Akshaybunny18/5bit-CLA-Adder-VLSI/Verilog/FPGA/project_1.runs/impl_1/.vivado.begin.rst

<?xml version="1.0"?>
<ProcessHandle Version="1" Minor="0">
    <Process Command="vivado.bat" Owner="aksha" Host="BUNNY" Pid="77792" HostCore="0" HostMemory="0">
    </Process>
</ProcessHandle>
<?xml version="1.0"?>
<ProcessHandle Version="1" Minor="0">
    <Process Command="vivado.bat" Owner="aksha" Host="BUNNY" Pid="55608" HostCore="0" HostMemory="0">
    </Process>
</ProcessHandle>
<?xml version="1.0"?>
<ProcessHandle Version="1" Minor="0">
    <Process Command="vivado.bat" Owner="aksha" Host="BUNNY" Pid="72820" HostCore="0" HostMemory="0">
    </Process>
</ProcessHandle>
<?xml version="1.0"?>
<ProcessHandle Version="1" Minor="0">
    <Process Command="vivado.bat" Owner="aksha" Host="BUNNY" Pid="8096" HostCore="0" HostMemory="0">
    </Process>
</ProcessHandle>
