Akshaybunny18/5bit-CLA-Adder-VLSI/Verilog/FPGA/project_1.runs/synth_1/.vivado.begin.rst

<?xml version="1.0"?>
<ProcessHandle Version="1" Minor="0">
    <Process Command="vivado.bat" Owner="aksha" Host="BUNNY" Pid="38688" HostCore="0" HostMemory="0">
    </Process>
</ProcessHandle>
