Akshaybunny18/5bit-CLA-Adder-VLSI/Ngspice/Post_Layout/ckt_final.cir

* Chanda Akshay Kumar 2024102014 VLSI Design
.include TSMC_180nm.txt
.param LAMBDA = 0.09u
.global gnd vdd

* Testbench
vdd vdd gnd 1.8


* SPICE3 file created from ckt_copy.ext - technology: scmos

.option scale=0.09u

M1000 vdd a_23_n261# a_94_n229# w_88_n235# CMOSP w=40 l=2
+  ad=16600 pd=6510 as=400 ps=180
M1001 g2 a_94_n331# vdd w_214_n354# CMOSP w=40 l=2
+  ad=200 pd=90 as=0 ps=0
M1002 gnd b3 a_156_n473# Gnd CMOSN w=40 l=2
+  ad=13100 pd=5840 as=240 ps=92
M1003 vdd a_851_n313# s3 w_925_n287# CMOSP w=40 l=2
+  ad=0 pd=0 as=400 ps=180
M1004 a_396_n200# g1 vdd w_390_n206# CMOSP w=40 l=2
+  ad=400 pd=180 as=0 ps=0
M1005 a_913_n196# p2 a_851_n203# Gnd CMOSN w=40 l=2
+  ad=240 pd=92 as=200 ps=90
M1006 vdd a_397_n323# a_576_n345# w_570_n351# CMOSP w=40 l=2
+  ad=0 pd=0 as=640 ps=272
M1007 a_913_n87# p1 a_851_n94# Gnd CMOSN w=40 l=2
+  ad=240 pd=92 as=200 ps=90
M1008 vdd b1 a_23_n111# w_17_n117# CMOSP w=40 l=2
+  ad=0 pd=0 as=400 ps=180
M1009 a_94_n331# b2 vdd w_88_n337# CMOSP w=40 l=2
+  ad=400 pd=180 as=0 ps=0
M1010 a_396_n521# g1 vdd w_390_n527# CMOSP w=40 l=2
+  ad=640 pd=272 as=0 ps=0
M1011 a_851_n30# g0 vdd w_845_n36# CMOSP w=40 l=2
+  ad=400 pd=180 as=0 ps=0
M1012 s2 a_851_n139# vdd w_925_n177# CMOSP w=40 l=2
+  ad=400 pd=180 as=0 ps=0
M1013 gnd a_23_n560# a_156_n585# Gnd CMOSN w=40 l=2
+  ad=0 pd=0 as=240 ps=92
M1014 c5 a_396_n459# a_608_n570# Gnd CMOSN w=100 l=2
+  ad=500 pd=210 as=600 ps=212
M1015 s4 a_851_n360# vdd w_925_n398# CMOSP w=40 l=2
+  ad=400 pd=180 as=0 ps=0
M1016 vdd a_94_n143# p1 w_168_n117# CMOSP w=40 l=2
+  ad=0 pd=0 as=400 ps=180
M1017 vdd p1 a_396_n459# w_390_n472# CMOSP w=40 l=2
+  ad=0 pd=0 as=680 ps=274
M1018 a_452_n277# p3 gnd Gnd CMOSN w=80 l=2
+  ad=480 pd=172 as=0 ps=0
M1019 vdd a3 a_94_n480# w_88_n486# CMOSP w=40 l=2
+  ad=0 pd=0 as=400 ps=180
M1020 a_913_n417# p4 a_851_n424# Gnd CMOSN w=40 l=2
+  ad=240 pd=92 as=200 ps=90
M1021 a_94_n32# b0 vdd w_88_n38# CMOSP w=40 l=2
+  ad=400 pd=180 as=0 ps=0
M1022 a_452_n498# p2 a_452_n506# Gnd CMOSN w=80 l=2
+  ad=480 pd=172 as=480 ps=172
M1023 a_396_n56# g0 vdd w_390_n62# CMOSP w=40 l=2
+  ad=400 pd=180 as=0 ps=0
M1024 a_236_n254# a_94_n293# p2 Gnd CMOSN w=40 l=2
+  ad=240 pd=92 as=200 ps=90
M1025 a_913_n132# a_780_n171# a_851_n139# Gnd CMOSN w=40 l=2
+  ad=240 pd=92 as=200 ps=90
M1026 a_913_n353# a_780_n392# a_851_n360# Gnd CMOSN w=40 l=2
+  ad=240 pd=92 as=200 ps=90
M1027 g4 a_94_n630# gnd Gnd CMOSN w=20 l=2
+  ad=100 pd=50 as=0 ps=0
M1028 a_913_n23# a_780_n62# a_851_n30# Gnd CMOSN w=40 l=2
+  ad=240 pd=92 as=200 ps=90
M1029 a_780_n62# g0 vdd w_774_n68# CMOSP w=40 l=2
+  ad=400 pd=180 as=0 ps=0
M1030 a_156_n174# a1 a_94_n181# Gnd CMOSN w=40 l=2
+  ad=240 pd=92 as=200 ps=90
M1031 a_851_n203# a_780_n171# vdd w_845_n209# CMOSP w=40 l=2
+  ad=400 pd=180 as=0 ps=0
M1032 a_397_n323# p3 vdd w_391_n336# CMOSP w=40 l=2
+  ad=440 pd=182 as=0 ps=0
M1033 vdd b4 a_94_n592# w_88_n598# CMOSP w=40 l=2
+  ad=0 pd=0 as=400 ps=180
M1034 vdd a_23_38# a_94_70# w_88_64# CMOSP w=40 l=2
+  ad=0 pd=0 as=400 ps=180
M1035 vdd a_94_n181# a_563_n64# w_557_n70# CMOSP w=40 l=2
+  ad=0 pd=0 as=400 ps=180
M1036 vdd p3 a_851_n313# w_845_n319# CMOSP w=40 l=2
+  ad=0 pd=0 as=400 ps=180
M1037 a_576_n345# a_396_n284# a_632_n322# Gnd CMOSN w=80 l=2
+  ad=400 pd=170 as=480 ps=172
M1038 a_397_n560# p3 vdd w_391_n573# CMOSP w=40 l=2
+  ad=440 pd=182 as=0 ps=0
M1039 a_453_n560# p4 gnd Gnd CMOSN w=60 l=2
+  ad=360 pd=132 as=0 ps=0
M1040 gnd a4 a_156_n521# Gnd CMOSN w=40 l=2
+  ad=0 pd=0 as=240 ps=92
M1041 g1 a_94_n181# gnd Gnd CMOSN w=20 l=2
+  ad=100 pd=50 as=0 ps=0
M1042 a_396_n284# p2 vdd w_390_n290# CMOSP w=40 l=2
+  ad=640 pd=272 as=0 ps=0
M1043 a_396_n521# p3 vdd w_390_n527# CMOSP w=40 l=2
+  ad=0 pd=0 as=0 ps=0
M1044 a_458_n601# g3 a_396_n608# Gnd CMOSN w=40 l=2
+  ad=240 pd=92 as=200 ps=90
M1045 gnd a3 a_85_n403# Gnd CMOSN w=40 l=2
+  ad=0 pd=0 as=240 ps=92
M1046 a_23_n261# a2 vdd w_17_n267# CMOSP w=40 l=2
+  ad=400 pd=180 as=0 ps=0
M1047 vdd a_780_n281# a_851_n249# w_845_n255# CMOSP w=40 l=2
+  ad=0 pd=0 as=400 ps=180
M1048 a_156_n286# b2 a_94_n293# Gnd CMOSN w=40 l=2
+  ad=240 pd=92 as=200 ps=90
M1049 a_396_n459# p3 vdd w_390_n472# CMOSP w=40 l=2
+  ad=0 pd=0 as=0 ps=0
M1050 a_156_77# a_23_38# a_94_70# Gnd CMOSN w=40 l=2
+  ad=240 pd=92 as=200 ps=90
M1051 a_458_n49# p1 a_396_n56# Gnd CMOSN w=40 l=2
+  ad=240 pd=92 as=200 ps=90
M1052 a_452_n443# g0 a_452_n451# Gnd CMOSN w=100 l=2
+  ad=600 pd=212 as=600 ps=212
M1053 vdd a_851_n94# s1 w_925_n68# CMOSP w=40 l=2
+  ad=0 pd=0 as=400 ps=180
M1054 gnd g2 a_458_n364# Gnd CMOSN w=40 l=2
+  ad=0 pd=0 as=240 ps=92
M1055 gnd b0 a_156_n25# Gnd CMOSN w=40 l=2
+  ad=0 pd=0 as=240 ps=92
M1056 a_842_n55# p1 a_780_n62# Gnd CMOSN w=40 l=2
+  ad=240 pd=92 as=200 ps=90
M1057 a_642_n168# a_94_n331# gnd Gnd CMOSN w=60 l=2
+  ad=360 pd=132 as=0 ps=0
M1058 p2 a_94_n229# vdd w_168_n267# CMOSP w=40 l=2
+  ad=400 pd=180 as=0 ps=0
M1059 a_993_n55# a_851_n94# s1 Gnd CMOSN w=40 l=2
+  ad=240 pd=92 as=200 ps=90
M1060 a_396_n608# p4 vdd w_390_n614# CMOSP w=40 l=2
+  ad=400 pd=180 as=0 ps=0
M1061 a_851_n139# a_563_n64# vdd w_845_n145# CMOSP w=40 l=2
+  ad=400 pd=180 as=0 ps=0
M1062 a_94_n143# a_23_n111# vdd w_88_n149# CMOSP w=40 l=2
+  ad=400 pd=180 as=0 ps=0
M1063 vdd a_23_n560# a_94_n528# w_88_n534# CMOSP w=40 l=2
+  ad=0 pd=0 as=400 ps=180
M1064 vdd b0 a_94_6# w_88_0# CMOSP w=40 l=2
+  ad=0 pd=0 as=400 ps=180
M1065 g0 a_94_n32# gnd Gnd CMOSN w=20 l=2
+  ad=100 pd=50 as=0 ps=0
M1066 a_851_n360# a_576_n345# vdd w_845_n366# CMOSP w=40 l=2
+  ad=400 pd=180 as=0 ps=0
M1067 g4 a_94_n630# vdd w_214_n653# CMOSP w=40 l=2
+  ad=200 pd=90 as=0 ps=0
M1068 a_453_n315# g1 a_453_n323# Gnd CMOSN w=60 l=2
+  ad=360 pd=132 as=360 ps=132
M1069 a_608_n586# a_396_n608# a_608_n594# Gnd CMOSN w=100 l=2
+  ad=600 pd=212 as=600 ps=212
M1070 gnd a_94_70# a_236_45# Gnd CMOSN w=40 l=2
+  ad=0 pd=0 as=240 ps=92
M1071 a_842_n164# p2 a_780_n171# Gnd CMOSN w=40 l=2
+  ad=240 pd=92 as=200 ps=90
M1072 vdd a_396_n200# a_586_n168# w_580_n181# CMOSP w=40 l=2
+  ad=0 pd=0 as=440 ps=182
M1073 g1 a_94_n181# vdd w_215_n204# CMOSP w=40 l=2
+  ad=200 pd=90 as=0 ps=0
M1074 a_156_n222# a_23_n261# a_94_n229# Gnd CMOSN w=40 l=2
+  ad=240 pd=92 as=200 ps=90
M1075 a_452_n261# p1 a_452_n269# Gnd CMOSN w=80 l=2
+  ad=480 pd=172 as=480 ps=172
M1076 vdd b3 a_23_n410# w_17_n416# CMOSP w=40 l=2
+  ad=0 pd=0 as=400 ps=180
M1077 a_842_n385# p4 a_780_n392# Gnd CMOSN w=40 l=2
+  ad=240 pd=92 as=200 ps=90
M1078 a_156_13# b0 a_94_6# Gnd CMOSN w=40 l=2
+  ad=240 pd=92 as=200 ps=90
M1079 a_94_n630# b4 vdd w_88_n636# CMOSP w=40 l=2
+  ad=400 pd=180 as=0 ps=0
M1080 c5 a_397_n560# vdd w_546_n607# CMOSP w=40 l=2
+  ad=680 pd=274 as=0 ps=0
M1081 vdd p1 a_397_n152# w_391_n165# CMOSP w=40 l=2
+  ad=0 pd=0 as=440 ps=182
M1082 vdd a_94_n442# p3 w_168_n416# CMOSP w=40 l=2
+  ad=0 pd=0 as=400 ps=180
M1083 a_23_n111# a1 vdd w_17_n117# CMOSP w=40 l=2
+  ad=0 pd=0 as=0 ps=0
M1084 a_993_n274# a_851_n313# s3 Gnd CMOSN w=40 l=2
+  ad=240 pd=92 as=200 ps=90
M1085 vdd b0 a_23_38# w_17_32# CMOSP w=40 l=2
+  ad=0 pd=0 as=400 ps=180
M1086 vdd p1 a_851_n94# w_845_n100# CMOSP w=40 l=2
+  ad=0 pd=0 as=400 ps=180
M1087 gnd a1 a_85_n104# Gnd CMOSN w=40 l=2
+  ad=0 pd=0 as=240 ps=92
M1088 vdd p3 a_780_n281# w_774_n287# CMOSP w=40 l=2
+  ad=0 pd=0 as=400 ps=180
M1089 gnd b2 a_156_n324# Gnd CMOSN w=40 l=2
+  ad=0 pd=0 as=240 ps=92
M1090 a_632_n338# a_94_n480# gnd Gnd CMOSN w=80 l=2
+  ad=480 pd=172 as=0 ps=0
M1091 a_236_n553# a_94_n592# p4 Gnd CMOSN w=40 l=2
+  ad=240 pd=92 as=200 ps=90
M1092 a_85_n104# b1 a_23_n111# Gnd CMOSN w=40 l=2
+  ad=0 pd=0 as=200 ps=90
M1093 gnd a_851_n139# a_993_n164# Gnd CMOSN w=40 l=2
+  ad=0 pd=0 as=240 ps=92
M1094 a_156_n473# a3 a_94_n480# Gnd CMOSN w=40 l=2
+  ad=0 pd=0 as=200 ps=90
M1095 a_780_n171# a_563_n64# vdd w_774_n177# CMOSP w=40 l=2
+  ad=400 pd=180 as=0 ps=0
M1096 gnd a_851_n360# a_993_n385# Gnd CMOSN w=40 l=2
+  ad=0 pd=0 as=240 ps=92
M1097 a_780_n392# a_576_n345# vdd w_774_n398# CMOSP w=40 l=2
+  ad=400 pd=180 as=0 ps=0
M1098 a_586_n168# a_397_n152# a_642_n160# Gnd CMOSN w=60 l=2
+  ad=300 pd=130 as=360 ps=132
M1099 vdd p2 a_396_n200# w_390_n206# CMOSP w=40 l=2
+  ad=0 pd=0 as=0 ps=0
M1100 a_576_n345# a_396_n371# vdd w_570_n351# CMOSP w=40 l=2
+  ad=0 pd=0 as=0 ps=0
M1101 gnd a_396_n56# a_625_n57# Gnd CMOSN w=40 l=2
+  ad=0 pd=0 as=240 ps=92
M1102 vdd a2 a_94_n331# w_88_n337# CMOSP w=40 l=2
+  ad=0 pd=0 as=0 ps=0
M1103 a_23_n560# a4 vdd w_17_n566# CMOSP w=40 l=2
+  ad=400 pd=180 as=0 ps=0
M1104 vdd p4 a_396_n521# w_390_n527# CMOSP w=40 l=2
+  ad=0 pd=0 as=0 ps=0
M1105 vdd a_780_n62# a_851_n30# w_845_n36# CMOSP w=40 l=2
+  ad=0 pd=0 as=0 ps=0
M1106 a_397_n152# g0 a_453_n144# Gnd CMOSN w=60 l=2
+  ad=300 pd=130 as=360 ps=132
M1107 vdd a_851_n203# s2 w_925_n177# CMOSP w=40 l=2
+  ad=0 pd=0 as=0 ps=0
M1108 a_156_n585# b4 a_94_n592# Gnd CMOSN w=40 l=2
+  ad=0 pd=0 as=200 ps=90
M1109 a_608_n570# a_396_n521# a_608_n578# Gnd CMOSN w=100 l=2
+  ad=0 pd=0 as=600 ps=212
M1110 vdd a_851_n424# s4 w_925_n398# CMOSP w=40 l=2
+  ad=0 pd=0 as=0 ps=0
M1111 gnd a_94_n79# a_236_n104# Gnd CMOSN w=40 l=2
+  ad=0 pd=0 as=240 ps=92
M1112 gnd a_780_n281# a_913_n306# Gnd CMOSN w=40 l=2
+  ad=0 pd=0 as=240 ps=92
M1113 a_396_n459# p4 vdd w_390_n472# CMOSP w=40 l=2
+  ad=0 pd=0 as=0 ps=0
M1114 p4 a_94_n528# vdd w_168_n566# CMOSP w=40 l=2
+  ad=400 pd=180 as=0 ps=0
M1115 vdd a0 a_94_n32# w_88_n38# CMOSP w=40 l=2
+  ad=0 pd=0 as=0 ps=0
M1116 a_94_n442# a_23_n410# vdd w_88_n448# CMOSP w=40 l=2
+  ad=400 pd=180 as=0 ps=0
M1117 vdd p1 a_396_n56# w_390_n62# CMOSP w=40 l=2
+  ad=0 pd=0 as=0 ps=0
M1118 g0 a_94_n32# vdd w_215_n55# CMOSP w=40 l=2
+  ad=200 pd=90 as=0 ps=0
M1119 c5 a_396_n459# vdd w_546_n607# CMOSP w=40 l=2
+  ad=0 pd=0 as=0 ps=0
M1120 a_85_45# b0 a_23_38# Gnd CMOSN w=40 l=2
+  ad=240 pd=92 as=200 ps=90
M1121 vdd p1 a_780_n62# w_774_n68# CMOSP w=40 l=2
+  ad=0 pd=0 as=0 ps=0
M1122 vdd p2 a_851_n203# w_845_n209# CMOSP w=40 l=2
+  ad=0 pd=0 as=0 ps=0
M1123 gnd a2 a_85_n254# Gnd CMOSN w=40 l=2
+  ad=0 pd=0 as=240 ps=92
M1124 a_94_n378# a3 vdd w_88_n384# CMOSP w=40 l=2
+  ad=400 pd=180 as=0 ps=0
M1125 a_94_70# a0 vdd w_88_64# CMOSP w=40 l=2
+  ad=0 pd=0 as=0 ps=0
M1126 gnd a_23_n111# a_156_n136# Gnd CMOSN w=40 l=2
+  ad=0 pd=0 as=240 ps=92
M1127 a_632_n322# a_397_n323# a_632_n330# Gnd CMOSN w=80 l=2
+  ad=0 pd=0 as=480 ps=172
M1128 vdd g2 a_397_n560# w_391_n573# CMOSP w=40 l=2
+  ad=0 pd=0 as=0 ps=0
M1129 a_156_n521# a_23_n560# a_94_n528# Gnd CMOSN w=40 l=2
+  ad=0 pd=0 as=200 ps=90
M1130 a_452_n506# g1 a_452_n514# Gnd CMOSN w=80 l=2
+  ad=0 pd=0 as=480 ps=172
M1131 gnd a_586_n168# a_913_n242# Gnd CMOSN w=40 l=2
+  ad=0 pd=0 as=240 ps=92
M1132 a_94_n79# a1 vdd w_88_n85# CMOSP w=40 l=2
+  ad=400 pd=180 as=0 ps=0
M1133 vdd b2 a_23_n261# w_17_n267# CMOSP w=40 l=2
+  ad=0 pd=0 as=0 ps=0
M1134 vdd p2 a_396_n459# w_390_n472# CMOSP w=40 l=2
+  ad=0 pd=0 as=0 ps=0
M1135 gnd a0 a_156_77# Gnd CMOSN w=40 l=2
+  ad=0 pd=0 as=0 ps=0
M1136 a_452_n451# p1 a_452_n459# Gnd CMOSN w=100 l=2
+  ad=0 pd=0 as=600 ps=212
M1137 vdd p4 a_851_n424# w_845_n430# CMOSP w=40 l=2
+  ad=0 pd=0 as=400 ps=180
M1138 a_458_n364# p3 a_396_n371# Gnd CMOSN w=40 l=2
+  ad=0 pd=0 as=200 ps=90
M1139 a_156_n25# a0 a_94_n32# Gnd CMOSN w=40 l=2
+  ad=0 pd=0 as=200 ps=90
M1140 vdd a_94_n293# p2 w_168_n267# CMOSP w=40 l=2
+  ad=0 pd=0 as=0 ps=0
M1141 gnd b4 a_156_n623# Gnd CMOSN w=40 l=2
+  ad=0 pd=0 as=240 ps=92
M1142 gnd a_780_n62# a_913_n87# Gnd CMOSN w=40 l=2
+  ad=0 pd=0 as=0 ps=0
M1143 vdd b1 a_94_n143# w_88_n149# CMOSP w=40 l=2
+  ad=0 pd=0 as=0 ps=0
M1144 vdd a_780_n171# a_851_n139# w_845_n145# CMOSP w=40 l=2
+  ad=0 pd=0 as=0 ps=0
M1145 a_85_n403# b3 a_23_n410# Gnd CMOSN w=40 l=2
+  ad=0 pd=0 as=200 ps=90
M1146 a_397_n323# p2 vdd w_391_n336# CMOSP w=40 l=2
+  ad=0 pd=0 as=0 ps=0
M1147 vdd a_780_n392# a_851_n360# w_845_n366# CMOSP w=40 l=2
+  ad=0 pd=0 as=0 ps=0
M1148 vdd a_94_6# p0 w_168_32# CMOSP w=40 l=2
+  ad=0 pd=0 as=400 ps=180
M1149 a_453_n323# p3 gnd Gnd CMOSN w=60 l=2
+  ad=0 pd=0 as=0 ps=0
M1150 a_608_n594# a_94_n630# gnd Gnd CMOSN w=100 l=2
+  ad=0 pd=0 as=0 ps=0
M1151 gnd a_94_n378# a_236_n403# Gnd CMOSN w=40 l=2
+  ad=0 pd=0 as=240 ps=92
M1152 a_397_n560# p3 a_453_n552# Gnd CMOSN w=60 l=2
+  ad=300 pd=130 as=360 ps=132
M1153 a_396_n284# g0 vdd w_390_n290# CMOSP w=40 l=2
+  ad=0 pd=0 as=0 ps=0
M1154 gnd a_780_n392# a_913_n417# Gnd CMOSN w=40 l=2
+  ad=0 pd=0 as=0 ps=0
M1155 a_452_n269# p2 a_452_n277# Gnd CMOSN w=80 l=2
+  ad=0 pd=0 as=0 ps=0
M1156 vdd g3 a_396_n608# w_390_n614# CMOSP w=40 l=2
+  ad=0 pd=0 as=0 ps=0
M1157 a_396_n521# p3 a_452_n498# Gnd CMOSN w=80 l=2
+  ad=400 pd=170 as=0 ps=0
M1158 vdd a4 a_94_n630# w_88_n636# CMOSP w=40 l=2
+  ad=0 pd=0 as=0 ps=0
M1159 a_396_n459# p3 a_452_n435# Gnd CMOSN w=100 l=2
+  ad=500 pd=210 as=600 ps=212
M1160 gnd a1 a_156_n72# Gnd CMOSN w=40 l=2
+  ad=0 pd=0 as=240 ps=92
M1161 vdd a_396_n608# c5 w_546_n607# CMOSP w=40 l=2
+  ad=0 pd=0 as=0 ps=0
M1162 a_397_n152# p2 vdd w_391_n165# CMOSP w=40 l=2
+  ad=0 pd=0 as=0 ps=0
M1163 a_94_n181# b1 vdd w_88_n187# CMOSP w=40 l=2
+  ad=400 pd=180 as=0 ps=0
M1164 a_396_n371# g2 vdd w_390_n377# CMOSP w=40 l=2
+  ad=400 pd=180 as=0 ps=0
M1165 a_563_n64# a_396_n56# vdd w_557_n70# CMOSP w=40 l=2
+  ad=0 pd=0 as=0 ps=0
M1166 gnd a_586_n168# a_842_n274# Gnd CMOSN w=40 l=2
+  ad=0 pd=0 as=240 ps=92
M1167 a_23_38# a0 vdd w_17_32# CMOSP w=40 l=2
+  ad=0 pd=0 as=0 ps=0
M1168 a_156_n324# a2 a_94_n331# Gnd CMOSN w=40 l=2
+  ad=0 pd=0 as=200 ps=90
M1169 p1 a_94_n79# vdd w_168_n117# CMOSP w=40 l=2
+  ad=0 pd=0 as=0 ps=0
M1170 a_993_n164# a_851_n203# s2 Gnd CMOSN w=40 l=2
+  ad=0 pd=0 as=200 ps=90
M1171 a_94_n293# a_23_n261# vdd w_88_n299# CMOSP w=40 l=2
+  ad=400 pd=180 as=0 ps=0
M1172 gnd a4 a_85_n553# Gnd CMOSN w=40 l=2
+  ad=0 pd=0 as=240 ps=92
M1173 vdd p2 a_780_n171# w_774_n177# CMOSP w=40 l=2
+  ad=0 pd=0 as=0 ps=0
M1174 gnd g1 a_458_n193# Gnd CMOSN w=40 l=2
+  ad=0 pd=0 as=240 ps=92
M1175 a_993_n385# a_851_n424# s4 Gnd CMOSN w=40 l=2
+  ad=0 pd=0 as=200 ps=90
M1176 vdd p4 a_780_n392# w_774_n398# CMOSP w=40 l=2
+  ad=0 pd=0 as=0 ps=0
M1177 a_642_n160# a_396_n200# a_642_n168# Gnd CMOSN w=60 l=2
+  ad=0 pd=0 as=0 ps=0
M1178 gnd a_23_n410# a_156_n435# Gnd CMOSN w=40 l=2
+  ad=0 pd=0 as=240 ps=92
M1179 g3 a_94_n480# gnd Gnd CMOSN w=20 l=2
+  ad=100 pd=50 as=0 ps=0
M1180 vdd b4 a_23_n560# w_17_n566# CMOSP w=40 l=2
+  ad=0 pd=0 as=0 ps=0
M1181 gnd a3 a_156_n371# Gnd CMOSN w=40 l=2
+  ad=0 pd=0 as=240 ps=92
M1182 a_453_n144# p1 a_453_n152# Gnd CMOSN w=60 l=2
+  ad=0 pd=0 as=360 ps=132
M1183 a_236_n104# a_94_n143# p1 Gnd CMOSN w=40 l=2
+  ad=0 pd=0 as=200 ps=90
M1184 vdd p3 a_396_n284# w_390_n290# CMOSP w=40 l=2
+  ad=0 pd=0 as=0 ps=0
M1185 vdd a_94_n592# p4 w_168_n566# CMOSP w=40 l=2
+  ad=0 pd=0 as=0 ps=0
M1186 vdd p2 a_396_n521# w_390_n527# CMOSP w=40 l=2
+  ad=0 pd=0 as=0 ps=0
M1187 a_94_n229# a2 vdd w_88_n235# CMOSP w=40 l=2
+  ad=0 pd=0 as=0 ps=0
M1188 vdd b3 a_94_n442# w_88_n448# CMOSP w=40 l=2
+  ad=0 pd=0 as=0 ps=0
M1189 s3 a_851_n249# vdd w_925_n287# CMOSP w=40 l=2
+  ad=0 pd=0 as=0 ps=0
M1190 vdd a_396_n521# c5 w_546_n607# CMOSP w=40 l=2
+  ad=0 pd=0 as=0 ps=0
M1191 gnd a_780_n171# a_913_n196# Gnd CMOSN w=40 l=2
+  ad=0 pd=0 as=0 ps=0
M1192 gnd a0 a_85_45# Gnd CMOSN w=40 l=2
+  ad=0 pd=0 as=0 ps=0
M1193 a_85_n254# b2 a_23_n261# Gnd CMOSN w=40 l=2
+  ad=0 pd=0 as=200 ps=90
M1194 a_576_n345# a_396_n284# vdd w_570_n351# CMOSP w=40 l=2
+  ad=0 pd=0 as=0 ps=0
M1195 g3 a_94_n480# vdd w_214_n503# CMOSP w=40 l=2
+  ad=200 pd=90 as=0 ps=0
M1196 vdd a_23_n410# a_94_n378# w_88_n384# CMOSP w=40 l=2
+  ad=0 pd=0 as=0 ps=0
M1197 a_851_n94# a_780_n62# vdd w_845_n100# CMOSP w=40 l=2
+  ad=0 pd=0 as=0 ps=0
M1198 a_156_n136# b1 a_94_n143# Gnd CMOSN w=40 l=2
+  ad=0 pd=0 as=200 ps=90
M1199 a_913_n306# p3 a_851_n313# Gnd CMOSN w=40 l=2
+  ad=0 pd=0 as=200 ps=90
M1200 a_632_n330# a_396_n371# a_632_n338# Gnd CMOSN w=80 l=2
+  ad=0 pd=0 as=0 ps=0
M1201 a_397_n560# p4 vdd w_391_n573# CMOSP w=40 l=2
+  ad=0 pd=0 as=0 ps=0
M1202 a_94_6# a_23_38# vdd w_88_0# CMOSP w=40 l=2
+  ad=0 pd=0 as=0 ps=0
M1203 a_452_n514# p4 gnd Gnd CMOSN w=80 l=2
+  ad=0 pd=0 as=0 ps=0
M1204 a_913_n242# a_780_n281# a_851_n249# Gnd CMOSN w=40 l=2
+  ad=0 pd=0 as=200 ps=90
M1205 vdd a_23_n111# a_94_n79# w_88_n85# CMOSP w=40 l=2
+  ad=0 pd=0 as=0 ps=0
M1206 a_396_n459# g0 vdd w_390_n472# CMOSP w=40 l=2
+  ad=0 pd=0 as=0 ps=0
M1207 a_851_n313# a_780_n281# vdd w_845_n319# CMOSP w=40 l=2
+  ad=0 pd=0 as=0 ps=0
M1208 a_94_n480# b3 vdd w_88_n486# CMOSP w=40 l=2
+  ad=0 pd=0 as=0 ps=0
M1209 a_452_n459# p4 gnd Gnd CMOSN w=100 l=2
+  ad=0 pd=0 as=0 ps=0
M1210 a_586_n168# a_94_n331# vdd w_580_n181# CMOSP w=40 l=2
+  ad=0 pd=0 as=0 ps=0
M1211 gnd a_23_38# a_156_13# Gnd CMOSN w=40 l=2
+  ad=0 pd=0 as=0 ps=0
M1212 gnd a_94_n229# a_236_n254# Gnd CMOSN w=40 l=2
+  ad=0 pd=0 as=0 ps=0
M1213 a_156_n623# a4 a_94_n630# Gnd CMOSN w=40 l=2
+  ad=0 pd=0 as=200 ps=90
M1214 gnd p4 a_458_n601# Gnd CMOSN w=40 l=2
+  ad=0 pd=0 as=0 ps=0
M1215 gnd a_563_n64# a_913_n132# Gnd CMOSN w=40 l=2
+  ad=0 pd=0 as=0 ps=0
M1216 gnd a_576_n345# a_913_n353# Gnd CMOSN w=40 l=2
+  ad=0 pd=0 as=0 ps=0
M1217 gnd g0 a_913_n23# Gnd CMOSN w=40 l=2
+  ad=0 pd=0 as=0 ps=0
M1218 gnd b1 a_156_n174# Gnd CMOSN w=40 l=2
+  ad=0 pd=0 as=0 ps=0
M1219 vdd g1 a_397_n323# w_391_n336# CMOSP w=40 l=2
+  ad=0 pd=0 as=0 ps=0
M1220 a_94_n592# a_23_n560# vdd w_88_n598# CMOSP w=40 l=2
+  ad=0 pd=0 as=0 ps=0
M1221 p0 a_94_70# vdd w_168_32# CMOSP w=40 l=2
+  ad=0 pd=0 as=0 ps=0
M1222 a_453_n552# g2 a_453_n560# Gnd CMOSN w=60 l=2
+  ad=0 pd=0 as=0 ps=0
M1223 vdd p1 a_396_n284# w_390_n290# CMOSP w=40 l=2
+  ad=0 pd=0 as=0 ps=0
M1224 a_851_n249# a_586_n168# vdd w_845_n255# CMOSP w=40 l=2
+  ad=0 pd=0 as=0 ps=0
M1225 gnd a_23_n261# a_156_n286# Gnd CMOSN w=40 l=2
+  ad=0 pd=0 as=0 ps=0
M1226 gnd g0 a_458_n49# Gnd CMOSN w=40 l=2
+  ad=0 pd=0 as=0 ps=0
M1227 a_452_n435# p2 a_452_n443# Gnd CMOSN w=100 l=2
+  ad=0 pd=0 as=0 ps=0
M1228 s1 a_851_n30# vdd w_925_n68# CMOSP w=40 l=2
+  ad=0 pd=0 as=0 ps=0
M1229 a_156_n72# a_23_n111# a_94_n79# Gnd CMOSN w=40 l=2
+  ad=0 pd=0 as=200 ps=90
M1230 c5 a_94_n630# vdd w_546_n607# CMOSP w=40 l=2
+  ad=0 pd=0 as=0 ps=0
M1231 a_236_n403# a_94_n442# p3 Gnd CMOSN w=40 l=2
+  ad=0 pd=0 as=200 ps=90
M1232 gnd g0 a_842_n55# Gnd CMOSN w=40 l=2
+  ad=0 pd=0 as=0 ps=0
M1233 vdd a1 a_94_n181# w_88_n187# CMOSP w=40 l=2
+  ad=0 pd=0 as=0 ps=0
M1234 vdd p3 a_396_n371# w_390_n377# CMOSP w=40 l=2
+  ad=0 pd=0 as=0 ps=0
M1235 a_625_n57# a_94_n181# a_563_n64# Gnd CMOSN w=40 l=2
+  ad=0 pd=0 as=200 ps=90
M1236 gnd a_851_n30# a_993_n55# Gnd CMOSN w=40 l=2
+  ad=0 pd=0 as=0 ps=0
M1237 a_842_n274# p3 a_780_n281# Gnd CMOSN w=40 l=2
+  ad=0 pd=0 as=200 ps=90
M1238 vdd a_94_n480# a_576_n345# w_570_n351# CMOSP w=40 l=2
+  ad=0 pd=0 as=0 ps=0
M1239 a_23_n410# a3 vdd w_17_n416# CMOSP w=40 l=2
+  ad=0 pd=0 as=0 ps=0
M1240 a_94_n528# a4 vdd w_88_n534# CMOSP w=40 l=2
+  ad=0 pd=0 as=0 ps=0
M1241 a_397_n323# p2 a_453_n315# Gnd CMOSN w=60 l=2
+  ad=300 pd=130 as=0 ps=0
M1242 a_608_n578# a_397_n560# a_608_n586# Gnd CMOSN w=100 l=2
+  ad=0 pd=0 as=0 ps=0
M1243 g2 a_94_n331# gnd Gnd CMOSN w=20 l=2
+  ad=100 pd=50 as=0 ps=0
M1244 p3 a_94_n378# vdd w_168_n416# CMOSP w=40 l=2
+  ad=0 pd=0 as=0 ps=0
M1245 a_236_45# a_94_6# p0 Gnd CMOSN w=40 l=2
+  ad=0 pd=0 as=200 ps=90
M1246 gnd a_563_n64# a_842_n164# Gnd CMOSN w=40 l=2
+  ad=0 pd=0 as=0 ps=0
M1247 vdd b2 a_94_n293# w_88_n299# CMOSP w=40 l=2
+  ad=0 pd=0 as=0 ps=0
M1248 a_85_n553# b4 a_23_n560# Gnd CMOSN w=40 l=2
+  ad=0 pd=0 as=200 ps=90
M1249 gnd a_576_n345# a_842_n385# Gnd CMOSN w=40 l=2
+  ad=0 pd=0 as=0 ps=0
M1250 a_586_n168# a_397_n152# vdd w_580_n181# CMOSP w=40 l=2
+  ad=0 pd=0 as=0 ps=0
M1251 a_458_n193# p2 a_396_n200# Gnd CMOSN w=40 l=2
+  ad=0 pd=0 as=200 ps=90
M1252 gnd a2 a_156_n222# Gnd CMOSN w=40 l=2
+  ad=0 pd=0 as=0 ps=0
M1253 a_396_n284# g0 a_452_n261# Gnd CMOSN w=80 l=2
+  ad=400 pd=170 as=0 ps=0
M1254 a_851_n424# a_780_n392# vdd w_845_n430# CMOSP w=40 l=2
+  ad=0 pd=0 as=0 ps=0
M1255 a_156_n435# b3 a_94_n442# Gnd CMOSN w=40 l=2
+  ad=0 pd=0 as=200 ps=90
M1256 a_397_n152# g0 vdd w_391_n165# CMOSP w=40 l=2
+  ad=0 pd=0 as=0 ps=0
M1257 a_156_n371# a_23_n410# a_94_n378# Gnd CMOSN w=40 l=2
+  ad=0 pd=0 as=200 ps=90
M1258 a_453_n152# p2 gnd Gnd CMOSN w=60 l=2
+  ad=0 pd=0 as=0 ps=0
M1259 gnd a_851_n249# a_993_n274# Gnd CMOSN w=40 l=2
+  ad=0 pd=0 as=0 ps=0
M1260 a_780_n281# a_586_n168# vdd w_774_n287# CMOSP w=40 l=2
+  ad=0 pd=0 as=0 ps=0
M1261 gnd a_94_n528# a_236_n553# Gnd CMOSN w=40 l=2
+  ad=0 pd=0 as=0 ps=0
C0 gnd a_586_n168# 0.07fF
C1 a_396_n608# w_390_n614# 0.14fF
C2 a_156_n136# a_94_n143# 0.45fF
C3 w_88_n598# a_23_n560# 0.08fF
C4 a_851_n139# a_913_n132# 0.41fF
C5 g0 p1 2.17fF
C6 a_23_n410# b3 0.40fF
C7 vdd w_391_n165# 0.12fF
C8 gnd a_156_n136# 0.41fF
C9 a_780_n62# w_845_n100# 0.08fF
C10 gnd g4 0.21fF
C11 a_851_n203# a_780_n171# 0.15fF
C12 gnd a_458_n601# 0.41fF
C13 a_608_n578# a_608_n586# 1.03fF
C14 a_94_n79# w_168_n117# 0.08fF
C15 g0 a_94_n331# 0.09fF
C16 gnd a_993_n385# 0.41fF
C17 w_17_32# a_23_38# 0.14fF
C18 a_913_n417# a_851_n424# 0.45fF
C19 gnd a_156_n473# 0.41fF
C20 p1 w_168_n117# 0.14fF
C21 g0 p4 0.03fF
C22 g1 a_396_n459# 0.13fF
C23 a_396_n56# p1 0.08fF
C24 vdd a_851_n424# 0.93fF
C25 vdd a_780_n171# 1.18fF
C26 gnd a_236_n254# 0.41fF
C27 w_570_n351# a_396_n371# 0.08fF
C28 w_88_n187# a1 0.08fF
C29 vdd a_780_n62# 1.18fF
C30 p2 w_168_n267# 0.14fF
C31 w_88_n448# a_23_n410# 0.08fF
C32 g4 a_94_n630# 0.47fF
C33 gnd a_156_n222# 0.41fF
C34 vdd a_23_n261# 1.18fF
C35 a4 w_88_n636# 0.08fF
C36 a_397_n323# w_391_n336# 0.10fF
C37 p2 a_396_n521# 0.34fF
C38 gnd a_156_n585# 0.41fF
C39 p2 a_94_n229# 0.08fF
C40 w_570_n351# g1 0.13fF
C41 a_396_n200# a_397_n152# 0.27fF
C42 a_993_n274# s3 0.41fF
C43 vdd w_845_n255# 0.47fF
C44 gnd a_85_n553# 0.41fF
C45 a_23_n111# b1 0.40fF
C46 gnd p0 0.15fF
C47 gnd a_156_13# 0.41fF
C48 s4 a_851_n360# 0.08fF
C49 a_452_n498# a_396_n521# 0.82fF
C50 g0 a_851_n30# 0.08fF
C51 a_156_n25# a_94_n32# 0.41fF
C52 p1 a_94_n480# 0.08fF
C53 a3 a_94_n480# 0.08fF
C54 p4 a_576_n345# 0.27fF
C55 w_774_n398# a_576_n345# 0.08fF
C56 w_546_n607# a_396_n608# 0.08fF
C57 a_94_70# a0 0.08fF
C58 gnd a_85_n403# 0.41fF
C59 p2 a_586_n168# 0.14fF
C60 gnd a_94_n143# 0.12fF
C61 a_396_n200# w_390_n206# 0.14fF
C62 vdd b2 0.24fF
C63 a_94_n480# p4 0.51fF
C64 gnd a_842_n274# 0.41fF
C65 a_453_n144# a_397_n152# 0.62fF
C66 w_845_n36# a_851_n30# 0.14fF
C67 vdd w_925_n287# 0.05fF
C68 a_396_n284# p3 0.08fF
C69 p2 w_390_n290# 0.08fF
C70 a_94_n480# w_88_n486# 0.14fF
C71 a_642_n160# a_642_n168# 0.62fF
C72 a_94_n229# a2 0.08fF
C73 gnd a_563_n64# 0.79fF
C74 w_390_n527# p3 0.08fF
C75 w_88_n337# b2 0.08fF
C76 a_94_6# a_94_70# 0.31fF
C77 a_851_n139# w_845_n145# 0.14fF
C78 vdd a_397_n152# 1.46fF
C79 w_214_n653# g4 0.06fF
C80 gnd a_156_n435# 0.41fF
C81 g0 g2 0.04fF
C82 a0 a_94_n32# 0.08fF
C83 a_842_n55# a_780_n62# 0.41fF
C84 vdd c5 2.23fF
C85 a_94_n480# b3 0.08fF
C86 vdd w_88_n149# 0.11fF
C87 p2 a_236_n254# 0.41fF
C88 gnd a_94_n630# 0.14fF
C89 g1 w_391_n336# 0.08fF
C90 a_993_n55# s1 0.41fF
C91 vdd w_390_n206# 0.13fF
C92 gnd a_94_n442# 0.12fF
C93 w_88_n598# a_94_n592# 0.14fF
C94 a_396_n608# a_458_n601# 0.41fF
C95 vdd a_396_n200# 1.27fF
C96 vdd a_396_n284# 1.97fF
C97 p1 a_851_n94# 0.15fF
C98 vdd p3 1.73fF
C99 vdd w_390_n527# 0.09fF
C100 gnd a_453_n560# 0.66fF
C101 vdd a_94_n528# 1.30fF
C102 a_94_n442# a_156_n435# 0.45fF
C103 w_845_n319# a_780_n281# 0.08fF
C104 vdd w_845_n100# 0.11fF
C105 vdd a_851_n203# 0.93fF
C106 vdd b0 0.24fF
C107 gnd a_625_n57# 0.41fF
C108 p1 w_390_n472# 0.08fF
C109 c5 a_396_n459# 0.20fF
C110 a_94_n378# a3 0.08fF
C111 a_780_n62# w_774_n68# 0.14fF
C112 g2 a_94_n480# 0.09fF
C113 a_851_n94# w_925_n68# 0.08fF
C114 a_625_n57# a_563_n64# 0.41fF
C115 vdd s1 0.90fF
C116 gnd p2 0.71fF
C117 w_845_n430# a_851_n424# 0.14fF
C118 w_88_0# a_23_38# 0.08fF
C119 a_851_n203# s2 0.08fF
C120 a_23_n111# a_94_n143# 0.15fF
C121 p2 a_563_n64# 0.27fF
C122 a_397_n323# a_453_n315# 0.62fF
C123 gnd a_913_n353# 0.41fF
C124 g1 a_452_n514# 0.01fF
C125 w_925_n287# a_851_n313# 0.08fF
C126 w_390_n472# p4 0.08fF
C127 vdd b4 0.24fF
C128 a_396_n459# p3 0.08fF
C129 a_851_n94# a_851_n30# 0.31fF
C130 gnd a_236_n403# 0.41fF
C131 vdd w_88_n337# 0.05fF
C132 vdd s2 0.90fF
C133 gnd a_156_n174# 0.41fF
C134 a_23_n111# a1 0.40fF
C135 vdd a_94_n181# 2.01fF
C136 w_17_32# b0 0.08fF
C137 p1 g1 0.57fF
C138 w_570_n351# a_396_n284# 0.08fF
C139 gnd a_396_n608# 0.11fF
C140 a_85_n254# a_23_n261# 0.41fF
C141 a0 w_88_64# 0.08fF
C142 g0 w_390_n290# 0.08fF
C143 a_453_n552# a_397_n560# 0.62fF
C144 a0 a_23_38# 0.40fF
C145 g1 a_94_n331# 0.22fF
C146 w_214_n653# a_94_n630# 0.15fF
C147 a_23_n410# a_85_n403# 0.41fF
C148 a_396_n371# w_390_n377# 0.14fF
C149 gnd a_993_n274# 0.41fF
C150 a_851_n313# p3 0.15fF
C151 g1 p4 0.34fF
C152 vdd a_396_n459# 2.27fF
C153 a_632_n330# a_632_n338# 0.82fF
C154 p1 w_391_n165# 0.08fF
C155 w_845_n145# a_780_n171# 0.08fF
C156 vdd w_17_32# 0.06fF
C157 a_780_n392# a_851_n360# 0.08fF
C158 a_632_n322# a_576_n345# 0.82fF
C159 a_396_n608# a_94_n630# 0.37fF
C160 w_925_n398# a_851_n424# 0.08fF
C161 a_94_6# a_23_38# 0.15fF
C162 vdd a_842_n55# 0.09fF
C163 vdd w_570_n351# 0.08fF
C164 gnd w_845_n319# 0.03fF
C165 p2 a_452_n498# 0.01fF
C166 a_563_n64# w_774_n177# 0.08fF
C167 gnd a_851_n360# 0.04fF
C168 p1 a_780_n62# 0.40fF
C169 vdd a_851_n313# 0.93fF
C170 gnd w_88_n598# 0.03fF
C171 a_94_n480# a_156_n473# 0.41fF
C172 w_88_n38# a_94_n32# 0.14fF
C173 w_391_n336# p3 0.08fF
C174 p2 a_452_n435# 0.02fF
C175 a_94_n442# a_23_n410# 0.15fF
C176 vdd w_168_32# 0.05fF
C177 vdd w_88_n85# 0.47fF
C178 p4 a_851_n424# 0.15fF
C179 gnd g0 0.21fF
C180 a_94_n293# w_88_n299# 0.14fF
C181 g2 a_396_n371# 0.08fF
C182 w_168_n117# a_94_n143# 0.08fF
C183 vdd w_774_n68# 0.06fF
C184 w_17_n566# b4 0.08fF
C185 vdd w_17_n566# 0.06fF
C186 gnd a_156_n286# 0.41fF
C187 w_214_n503# a_94_n480# 0.08fF
C188 a_94_70# p0 0.08fF
C189 a_780_n392# a_576_n345# 0.40fF
C190 g1 g2 0.38fF
C191 gnd w_168_n117# 0.31fF
C192 a_156_n324# a_94_n331# 0.41fF
C193 vdd w_845_n430# 0.11fF
C194 w_88_n235# a_94_n229# 0.14fF
C195 vdd w_214_n354# 0.06fF
C196 a_452_n506# a_452_n498# 0.82fF
C197 a4 a_94_n528# 0.08fF
C198 w_557_n70# vdd 0.05fF
C199 gnd a_608_n594# 1.03fF
C200 b2 a_94_n331# 0.08fF
C201 vdd w_845_n366# 0.47fF
C202 a_396_n56# a_563_n64# 0.08fF
C203 vdd w_391_n336# 0.12fF
C204 a_780_n62# a_851_n30# 0.08fF
C205 w_391_n573# p3 0.08fF
C206 gnd a_576_n345# 0.07fF
C207 p2 w_774_n177# 0.08fF
C208 p1 a_397_n152# 0.08fF
C209 gnd a_94_70# 0.04fF
C210 gnd w_168_n416# 0.31fF
C211 w_557_n70# a_94_n181# 0.08fF
C212 gnd a_94_n480# 0.11fF
C213 a_913_n353# a_851_n360# 0.41fF
C214 a_94_n293# w_168_n267# 0.08fF
C215 vdd a_85_n254# 0.09fF
C216 s4 a_851_n424# 0.08fF
C217 w_88_0# b0 0.08fF
C218 a4 b4 0.94fF
C219 vdd a4 0.56fF
C220 a_396_n200# a_458_n193# 0.41fF
C221 a_94_n293# a_94_n229# 0.31fF
C222 a_608_n578# a_608_n570# 1.03fF
C223 p1 a_396_n284# 0.08fF
C224 a_85_45# gnd 0.41fF
C225 p1 p3 0.42fF
C226 g0 p2 0.67fF
C227 c5 a_397_n560# 0.08fF
C228 vdd w_17_n117# 0.06fF
C229 vdd w_391_n573# 0.12fF
C230 a_396_n200# a_94_n331# 0.27fF
C231 a_452_n261# a_452_n269# 0.82fF
C232 a_23_n261# w_88_n299# 0.08fF
C233 a_23_n410# w_88_n384# 0.08fF
C234 g1 a_396_n521# 0.20fF
C235 vdd w_845_n145# 0.47fF
C236 p3 a_94_n331# 0.05fF
C237 p1 w_845_n100# 0.08fF
C238 a_94_n442# w_168_n416# 0.08fF
C239 vdd w_88_0# 0.11fF
C240 gnd w_925_n177# 0.31fF
C241 a_23_n560# a_94_n528# 0.08fF
C242 a_94_n528# w_88_n534# 0.14fF
C243 p4 p3 0.33fF
C244 vdd w_925_n398# 0.05fF
C245 w_390_n527# p4 0.08fF
C246 w_390_n377# p3 0.13fF
C247 a_94_n528# p4 0.08fF
C248 p3 a_397_n560# 0.08fF
C249 vdd a_94_n79# 1.30fF
C250 a0 b0 0.90fF
C251 p2 a_576_n345# 0.29fF
C252 gnd a_913_n196# 0.41fF
C253 vdd p1 1.76fF
C254 vdd a3 0.56fF
C255 b2 w_88_n299# 0.08fF
C256 gnd a_156_n521# 0.41fF
C257 gnd a_397_n323# 0.09fF
C258 g0 w_390_n62# 0.08fF
C259 a_23_n560# b4 0.40fF
C260 vdd a_23_n560# 1.18fF
C261 gnd a_851_n139# 0.04fF
C262 s1 w_925_n68# 0.14fF
C263 gnd a_642_n168# 0.62fF
C264 gnd a_851_n94# 0.12fF
C265 vdd a_94_n331# 1.95fF
C266 a_94_n630# w_88_n636# 0.14fF
C267 vdd w_88_n534# 0.47fF
C268 p2 a_94_n480# 0.01fF
C269 gnd a_842_n164# 0.41fF
C270 a_851_n139# a_563_n64# 0.08fF
C271 vdd a0 0.56fF
C272 p1 a_94_n181# 0.91fF
C273 a_94_6# b0 0.15fF
C274 vdd w_774_n398# 0.06fF
C275 w_925_n287# s3 0.14fF
C276 vdd w_17_n416# 0.06fF
C277 vdd p4 1.62fF
C278 vdd w_390_n377# 0.09fF
C279 vdd w_925_n68# 0.05fF
C280 w_88_n337# a_94_n331# 0.14fF
C281 vdd a_397_n560# 1.51fF
C282 vdd w_88_n486# 0.05fF
C283 a_94_n229# a_23_n261# 0.08fF
C284 gnd a_94_n378# 0.04fF
C285 a_396_n56# w_390_n62# 0.14fF
C286 vdd a_85_n104# 0.09fF
C287 s1 a_851_n30# 0.08fF
C288 c5 a_608_n570# 1.03fF
C289 a_453_n323# a_453_n315# 0.62fF
C290 a_632_n330# a_632_n322# 0.82fF
C291 p1 a_396_n459# 0.08fF
C292 a_94_6# vdd 0.93fF
C293 w_845_n255# a_780_n281# 0.08fF
C294 vdd b3 0.24fF
C295 vdd g3 0.52fF
C296 g2 p3 1.04fF
C297 vdd a_851_n30# 1.30fF
C298 w_845_n255# a_851_n249# 0.14fF
C299 gnd a_453_n552# 0.04fF
C300 a_780_n392# a_842_n385# 0.41fF
C301 a_851_n313# a_913_n306# 0.45fF
C302 gnd a_94_n293# 0.12fF
C303 w_17_n566# a4 0.08fF
C304 gnd a_913_n87# 0.41fF
C305 a_586_n168# w_845_n255# 0.08fF
C306 gnd a_396_n371# 0.00fF
C307 vdd w_390_n614# 0.06fF
C308 w_546_n607# c5 0.14fF
C309 a0 w_17_32# 0.08fF
C310 a_94_n442# a_94_n378# 0.31fF
C311 gnd g1 0.62fF
C312 gnd w_845_n209# 0.03fF
C313 gnd a_842_n385# 0.41fF
C314 p2 a_397_n323# 0.08fF
C315 a_156_n72# a_94_n79# 0.41fF
C316 vdd s4 0.90fF
C317 a_851_n360# a_576_n345# 0.08fF
C318 vdd w_88_n448# 0.11fF
C319 b1 w_88_n149# 0.08fF
C320 w_925_n287# a_851_n249# 0.08fF
C321 w_168_n566# a_94_n528# 0.08fF
C322 c5 a_396_n521# 0.08fF
C323 gnd a_453_n152# 0.62fF
C324 w_88_n85# a_94_n79# 0.14fF
C325 s2 a_993_n164# 0.41fF
C326 vdd w_88_n299# 0.11fF
C327 vdd g2 0.71fF
C328 a_94_n528# a_94_n592# 0.31fF
C329 g0 w_845_n36# 0.08fF
C330 g0 a_396_n56# 0.08fF
C331 p2 w_390_n472# 0.08fF
C332 a_586_n168# a_397_n152# 0.08fF
C333 a_453_n552# a_453_n560# 0.62fF
C334 vdd s3 0.90fF
C335 gnd a_458_n364# 0.41fF
C336 a_780_n392# a_851_n424# 0.15fF
C337 p1 w_774_n68# 0.08fF
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
