Akshaybunny18/5bit-CLA-Adder-VLSI/Ngspice/Post_Layout/ff&ckt.cir

* Chanda Akshay Kumar 2024102014 VLSI Design
.include TSMC_180nm.txt
.param LAMBDA = 0.09u
.global gnd vdd

* Testbench
vdd vdd gnd 1.8


* SPICE3 file created from ckt_final_copy.ext - technology: scmos

.option scale=0.09u

M1000 vdd a_23_n261# a_94_n229# w_88_n235# CMOSP w=40 l=2
+  ad=32600 pd=13550 as=400 ps=180
M1001 g2 a_94_n331# vdd w_214_n354# CMOSP w=40 l=2
+  ad=200 pd=90 as=0 ps=0
M1002 a3 a_n296_n473# gnd Gnd CMOSN w=20 l=2
+  ad=100 pd=50 as=22700 ps=10320
M1003 a_n297_n282# a_n346_n282# vdd w_n310_n288# CMOSP w=40 l=2
+  ad=200 pd=90 as=0 ps=0
M1004 gnd b3 a_156_n473# Gnd CMOSN w=40 l=2
+  ad=0 pd=0 as=240 ps=92
M1005 a_n294_n663# clk a_n294_n718# Gnd CMOSN w=40 l=2
+  ad=200 pd=90 as=240 ps=92
M1006 vdd a_851_n313# s3 w_925_n287# CMOSP w=40 l=2
+  ad=0 pd=0 as=400 ps=180
M1007 a2 a_n297_n282# gnd Gnd CMOSN w=20 l=2
+  ad=100 pd=50 as=0 ps=0
M1008 a_n383_n163# da1 gnd Gnd CMOSN w=20 l=2
+  ad=100 pd=50 as=0 ps=0
M1009 a_913_n196# p2 a_851_n203# Gnd CMOSN w=40 l=2
+  ad=240 pd=92 as=200 ps=90
M1010 a_396_n200# g1 vdd w_390_n206# CMOSP w=40 l=2
+  ad=400 pd=180 as=0 ps=0
M1011 a3 a_n296_n473# vdd w_n277_n493# CMOSP w=40 l=2
+  ad=200 pd=90 as=0 ps=0
M1012 vdd a_397_n323# a_576_n345# w_570_n351# CMOSP w=40 l=2
+  ad=0 pd=0 as=640 ps=272
M1013 vdd b1 a_23_n111# w_17_n117# CMOSP w=40 l=2
+  ad=0 pd=0 as=400 ps=180
M1014 a_913_n87# p1 a_851_n94# Gnd CMOSN w=40 l=2
+  ad=240 pd=92 as=200 ps=90
M1015 a_396_n521# g1 vdd w_390_n527# CMOSP w=40 l=2
+  ad=640 pd=272 as=0 ps=0
M1016 a_94_n331# b2 vdd w_88_n337# CMOSP w=40 l=2
+  ad=400 pd=180 as=0 ps=0
M1017 a_n295_n149# a_n344_n94# gnd Gnd CMOSN w=40 l=2
+  ad=240 pd=92 as=0 ps=0
M1018 gnd a_23_n560# a_156_n585# Gnd CMOSN w=40 l=2
+  ad=0 pd=0 as=240 ps=92
M1019 a_1229_n150# a_1180_n95# gnd Gnd CMOSN w=40 l=2
+  ad=240 pd=92 as=0 ps=0
M1020 s2 a_851_n139# vdd w_925_n177# CMOSP w=40 l=2
+  ad=400 pd=180 as=0 ps=0
M1021 a_1180_n95# clk vdd w_1167_n101# CMOSP w=40 l=2
+  ad=200 pd=90 as=0 ps=0
M1022 b1 a_n94_n95# vdd w_n75_n115# CMOSP w=40 l=2
+  ad=200 pd=90 as=0 ps=0
M1023 a_851_n30# g0 vdd w_845_n36# CMOSP w=40 l=2
+  ad=400 pd=180 as=0 ps=0
M1024 c5 a_396_n459# a_608_n570# Gnd CMOSN w=100 l=2
+  ad=500 pd=210 as=600 ps=212
M1025 a_1181_n664# clk vdd w_1168_n670# CMOSP w=40 l=2
+  ad=200 pd=90 as=0 ps=0
M1026 s4 a_851_n360# vdd w_925_n398# CMOSP w=40 l=2
+  ad=400 pd=180 as=0 ps=0
M1027 a_1179_n474# a_1140_n543# a_1179_n529# Gnd CMOSN w=40 l=2
+  ad=200 pd=90 as=240 ps=92
M1028 vdd a_94_n143# p1 w_168_n117# CMOSP w=40 l=2
+  ad=0 pd=0 as=400 ps=180
M1029 a_1179_98# clk vdd w_1166_92# CMOSP w=40 l=2
+  ad=200 pd=90 as=0 ps=0
M1030 vdd p1 a_396_n459# w_390_n472# CMOSP w=40 l=2
+  ad=0 pd=0 as=680 ps=274
M1031 a_n294_n663# a_n343_n663# vdd w_n307_n669# CMOSP w=40 l=2
+  ad=200 pd=90 as=0 ps=0
M1032 vdd a3 a_94_n480# w_88_n486# CMOSP w=40 l=2
+  ad=0 pd=0 as=400 ps=180
M1033 a_1178_n338# clk gnd Gnd CMOSN w=40 l=2
+  ad=240 pd=92 as=0 ps=0
M1034 a_913_n417# p4 a_851_n424# Gnd CMOSN w=40 l=2
+  ad=240 pd=92 as=200 ps=90
M1035 a_452_n277# p3 gnd Gnd CMOSN w=80 l=2
+  ad=480 pd=172 as=0 ps=0
M1036 a_94_n32# b0 vdd w_88_n38# CMOSP w=40 l=2
+  ad=400 pd=180 as=0 ps=0
M1037 a_452_n498# p2 a_452_n506# Gnd CMOSN w=80 l=2
+  ad=480 pd=172 as=480 ps=172
M1038 a_n183_29# clk a_n183_85# w_n196_78# CMOSP w=80 l=2
+  ad=480 pd=172 as=480 ps=172
M1039 a_236_n254# a_94_n293# p2 Gnd CMOSN w=40 l=2
+  ad=240 pd=92 as=200 ps=90
M1040 a_396_n56# g0 vdd w_390_n62# CMOSP w=40 l=2
+  ad=400 pd=180 as=0 ps=0
M1041 a_913_n132# a_780_n171# a_851_n139# Gnd CMOSN w=40 l=2
+  ad=240 pd=92 as=200 ps=90
M1042 a_913_n353# a_780_n392# a_851_n360# Gnd CMOSN w=40 l=2
+  ad=240 pd=92 as=200 ps=90
M1043 g4 a_94_n630# gnd Gnd CMOSN w=20 l=2
+  ad=100 pd=50 as=0 ps=0
M1044 a_156_n174# a1 a_94_n181# Gnd CMOSN w=40 l=2
+  ad=240 pd=92 as=200 ps=90
M1045 a_780_n62# g0 vdd w_774_n68# CMOSP w=40 l=2
+  ad=400 pd=180 as=0 ps=0
M1046 a_851_n203# a_780_n171# vdd w_845_n209# CMOSP w=40 l=2
+  ad=400 pd=180 as=0 ps=0
M1047 a_n344_n94# a_n383_n163# a_n344_n149# Gnd CMOSN w=40 l=2
+  ad=200 pd=90 as=240 ps=92
M1048 vdd b4 a_94_n592# w_88_n598# CMOSP w=40 l=2
+  ad=0 pd=0 as=400 ps=180
M1049 a_397_n323# p3 vdd w_391_n336# CMOSP w=40 l=2
+  ad=440 pd=182 as=0 ps=0
M1050 a_913_n23# a_780_n62# a_851_n30# Gnd CMOSN w=40 l=2
+  ad=240 pd=92 as=200 ps=90
M1051 a_n345_44# clk gnd Gnd CMOSN w=40 l=2
+  ad=240 pd=92 as=0 ps=0
M1052 a_576_n345# a_396_n284# a_632_n322# Gnd CMOSN w=80 l=2
+  ad=400 pd=170 as=480 ps=172
M1053 vdd a_94_n181# a_563_n64# w_557_n70# CMOSP w=40 l=2
+  ad=0 pd=0 as=400 ps=180
M1054 a_397_n560# p3 vdd w_391_n573# CMOSP w=40 l=2
+  ad=440 pd=182 as=0 ps=0
M1055 vdd a_23_38# a_94_70# w_88_64# CMOSP w=40 l=2
+  ad=0 pd=0 as=400 ps=180
M1056 a_1230_n664# clk a_1230_n719# Gnd CMOSN w=40 l=2
+  ad=200 pd=90 as=240 ps=92
M1057 a_n144_n529# clk gnd Gnd CMOSN w=40 l=2
+  ad=240 pd=92 as=0 ps=0
M1058 vdd p3 a_851_n313# w_845_n319# CMOSP w=40 l=2
+  ad=0 pd=0 as=400 ps=180
M1059 gnd a4 a_156_n521# Gnd CMOSN w=40 l=2
+  ad=0 pd=0 as=240 ps=92
M1060 a_453_n560# p4 gnd Gnd CMOSN w=60 l=2
+  ad=360 pd=132 as=0 ps=0
M1061 a_1228_n529# a_1179_n474# gnd Gnd CMOSN w=40 l=2
+  ad=240 pd=92 as=0 ps=0
M1062 a_396_n284# p2 vdd w_390_n290# CMOSP w=40 l=2
+  ad=640 pd=272 as=0 ps=0
M1063 g1 a_94_n181# gnd Gnd CMOSN w=20 l=2
+  ad=100 pd=50 as=0 ps=0
M1064 a_396_n521# p3 vdd w_390_n527# CMOSP w=40 l=2
+  ad=0 pd=0 as=0 ps=0
M1065 a_n182_n164# clk a_n182_n108# w_n195_n115# CMOSP w=80 l=2
+  ad=480 pd=172 as=480 ps=172
M1066 a_458_n601# g3 a_396_n608# Gnd CMOSN w=40 l=2
+  ad=240 pd=92 as=200 ps=90
M1067 gnd a3 a_85_n403# Gnd CMOSN w=40 l=2
+  ad=0 pd=0 as=240 ps=92
M1068 a_n94_n95# clk a_n94_n150# Gnd CMOSN w=40 l=2
+  ad=200 pd=90 as=240 ps=92
M1069 a_23_n261# a2 vdd w_17_n267# CMOSP w=40 l=2
+  ad=400 pd=180 as=0 ps=0
M1070 a_396_n459# p3 vdd w_390_n472# CMOSP w=40 l=2
+  ad=0 pd=0 as=0 ps=0
M1071 a_156_n286# b2 a_94_n293# Gnd CMOSN w=40 l=2
+  ad=240 pd=92 as=200 ps=90
M1072 vdd a_780_n281# a_851_n249# w_845_n255# CMOSP w=40 l=2
+  ad=0 pd=0 as=400 ps=180
M1073 a_458_n49# p1 a_396_n56# Gnd CMOSN w=40 l=2
+  ad=240 pd=92 as=200 ps=90
M1074 a_452_n443# g0 a_452_n451# Gnd CMOSN w=100 l=2
+  ad=600 pd=212 as=600 ps=212
M1075 a_156_77# a_23_38# a_94_70# Gnd CMOSN w=40 l=2
+  ad=240 pd=92 as=200 ps=90
M1076 a_435_98# a_396_29# a_435_43# Gnd CMOSN w=40 l=2
+  ad=200 pd=90 as=240 ps=92
M1077 a_n385_n351# clk a_n385_n295# w_n398_n302# CMOSP w=80 l=2
+  ad=480 pd=172 as=480 ps=172
M1078 vdd a_851_n94# s1 w_925_n68# CMOSP w=40 l=2
+  ad=0 pd=0 as=400 ps=180
M1079 a_n296_n473# clk a_n296_n528# Gnd CMOSN w=40 l=2
+  ad=200 pd=90 as=240 ps=92
M1080 gnd g2 a_458_n364# Gnd CMOSN w=40 l=2
+  ad=0 pd=0 as=240 ps=92
M1081 a_642_n168# a_94_n331# gnd Gnd CMOSN w=60 l=2
+  ad=360 pd=132 as=0 ps=0
M1082 gnd b0 a_156_n25# Gnd CMOSN w=40 l=2
+  ad=0 pd=0 as=240 ps=92
M1083 p2 a_94_n229# vdd w_168_n267# CMOSP w=40 l=2
+  ad=400 pd=180 as=0 ps=0
M1084 a_842_n55# p1 a_780_n62# Gnd CMOSN w=40 l=2
+  ad=240 pd=92 as=200 ps=90
M1085 a_1141_n164# clk a_1141_n108# w_1128_n115# CMOSP w=80 l=2
+  ad=480 pd=172 as=480 ps=172
M1086 a_396_n608# p4 vdd w_390_n614# CMOSP w=40 l=2
+  ad=400 pd=180 as=0 ps=0
M1087 a_993_n55# a_851_n94# s1 Gnd CMOSN w=40 l=2
+  ad=240 pd=92 as=200 ps=90
M1088 a_94_n143# a_23_n111# vdd w_88_n149# CMOSP w=40 l=2
+  ad=400 pd=180 as=0 ps=0
M1089 a_851_n139# a_563_n64# vdd w_845_n145# CMOSP w=40 l=2
+  ad=400 pd=180 as=0 ps=0
M1090 a_n182_n164# db1 gnd Gnd CMOSN w=20 l=2
+  ad=100 pd=50 as=0 ps=0
M1091 vdd a_23_n560# a_94_n528# w_88_n534# CMOSP w=40 l=2
+  ad=0 pd=0 as=400 ps=180
M1092 a_851_n360# a_576_n345# vdd w_845_n366# CMOSP w=40 l=2
+  ad=400 pd=180 as=0 ps=0
M1093 g4 a_94_n630# vdd w_214_n653# CMOSP w=40 l=2
+  ad=200 pd=90 as=0 ps=0
M1094 a_396_29# clk a_396_85# w_383_78# CMOSP w=80 l=2
+  ad=480 pd=172 as=480 ps=172
M1095 g0 a_94_n32# gnd Gnd CMOSN w=20 l=2
+  ad=100 pd=50 as=0 ps=0
M1096 vdd b0 a_94_6# w_88_0# CMOSP w=40 l=2
+  ad=0 pd=0 as=400 ps=180
M1097 a_1227_n283# a_1178_n283# vdd w_1214_n289# CMOSP w=40 l=2
+  ad=200 pd=90 as=0 ps=0
M1098 a_608_n586# a_396_n608# a_608_n594# Gnd CMOSN w=100 l=2
+  ad=600 pd=212 as=600 ps=212
M1099 a_453_n315# g1 a_453_n323# Gnd CMOSN w=60 l=2
+  ad=360 pd=132 as=360 ps=132
M1100 a_1140_n543# clk a_1140_n487# w_1127_n494# CMOSP w=80 l=2
+  ad=480 pd=172 as=480 ps=172
M1101 gnd a_94_70# a_236_45# Gnd CMOSN w=40 l=2
+  ad=0 pd=0 as=240 ps=92
M1102 a_842_n164# p2 a_780_n171# Gnd CMOSN w=40 l=2
+  ad=240 pd=92 as=200 ps=90
M1103 a_1139_n296# s3 vdd w_1126_n303# CMOSP w=80 l=2
+  ad=480 pd=172 as=0 ps=0
M1104 a_842_n385# p4 a_780_n392# Gnd CMOSN w=40 l=2
+  ad=240 pd=92 as=200 ps=90
M1105 b2 a_n96_n283# gnd Gnd CMOSN w=20 l=2
+  ad=100 pd=50 as=0 ps=0
M1106 a_452_n261# p1 a_452_n269# Gnd CMOSN w=80 l=2
+  ad=480 pd=172 as=480 ps=172
M1107 g1 a_94_n181# vdd w_215_n204# CMOSP w=40 l=2
+  ad=200 pd=90 as=0 ps=0
M1108 a_n296_n473# a_n345_n473# vdd w_n309_n479# CMOSP w=40 l=2
+  ad=200 pd=90 as=0 ps=0
M1109 a_156_n222# a_23_n261# a_94_n229# Gnd CMOSN w=40 l=2
+  ad=240 pd=92 as=200 ps=90
M1110 a_n382_n732# clk a_n382_n676# w_n395_n683# CMOSP w=80 l=2
+  ad=480 pd=172 as=480 ps=172
M1111 vdd b3 a_23_n410# w_17_n416# CMOSP w=40 l=2
+  ad=0 pd=0 as=400 ps=180
M1112 vdd a_396_n200# a_586_n168# w_580_n181# CMOSP w=40 l=2
+  ad=0 pd=0 as=440 ps=182
M1113 a_94_n630# b4 vdd w_88_n636# CMOSP w=40 l=2
+  ad=400 pd=180 as=0 ps=0
M1114 a_156_13# b0 a_94_6# Gnd CMOSN w=40 l=2
+  ad=240 pd=92 as=200 ps=90
M1115 a_1142_n677# c5 vdd w_1129_n684# CMOSP w=80 l=2
+  ad=480 pd=172 as=0 ps=0
M1116 b2 a_n96_n283# vdd w_n77_n303# CMOSP w=40 l=2
+  ad=200 pd=90 as=0 ps=0
M1117 c5 a_397_n560# vdd w_546_n607# CMOSP w=40 l=2
+  ad=680 pd=274 as=0 ps=0
M1118 a_1228_43# a_1179_98# gnd Gnd CMOSN w=40 l=2
+  ad=240 pd=92 as=0 ps=0
M1119 vdd a_94_n442# p3 w_168_n416# CMOSP w=40 l=2
+  ad=0 pd=0 as=400 ps=180
M1120 vdd p1 a_397_n152# w_391_n165# CMOSP w=40 l=2
+  ad=0 pd=0 as=440 ps=182
M1121 a_23_n111# a1 vdd w_17_n117# CMOSP w=40 l=2
+  ad=0 pd=0 as=0 ps=0
M1122 a_n385_n351# da2 gnd Gnd CMOSN w=20 l=2
+  ad=100 pd=50 as=0 ps=0
M1123 a_993_n274# a_851_n313# s3 Gnd CMOSN w=40 l=2
+  ad=240 pd=92 as=200 ps=90
M1124 vdd b0 a_23_38# w_17_32# CMOSP w=40 l=2
+  ad=0 pd=0 as=400 ps=180
M1125 a_632_n338# a_94_n480# gnd Gnd CMOSN w=80 l=2
+  ad=480 pd=172 as=0 ps=0
M1126 vdd p3 a_780_n281# w_774_n287# CMOSP w=40 l=2
+  ad=0 pd=0 as=400 ps=180
M1127 vdd p1 a_851_n94# w_845_n100# CMOSP w=40 l=2
+  ad=0 pd=0 as=400 ps=180
M1128 gnd b2 a_156_n324# Gnd CMOSN w=40 l=2
+  ad=0 pd=0 as=240 ps=92
M1129 gnd a1 a_85_n104# Gnd CMOSN w=40 l=2
+  ad=0 pd=0 as=240 ps=92
M1130 a_236_n553# a_94_n592# p4 Gnd CMOSN w=40 l=2
+  ad=240 pd=92 as=200 ps=90
M1131 a_n143_n95# a_n182_n164# a_n143_n150# Gnd CMOSN w=40 l=2
+  ad=200 pd=90 as=240 ps=92
M1132 b4 a_n93_n664# gnd Gnd CMOSN w=20 l=2
+  ad=100 pd=50 as=0 ps=0
M1133 a_n297_n337# a_n346_n282# gnd Gnd CMOSN w=40 l=2
+  ad=240 pd=92 as=0 ps=0
M1134 a_85_n104# b1 a_23_n111# Gnd CMOSN w=40 l=2
+  ad=0 pd=0 as=200 ps=90
M1135 S0_out a_484_98# vdd w_503_78# CMOSP w=40 l=2
+  ad=200 pd=90 as=0 ps=0
M1136 a_156_n473# a3 a_94_n480# Gnd CMOSN w=40 l=2
+  ad=0 pd=0 as=200 ps=90
M1137 gnd a_851_n139# a_993_n164# Gnd CMOSN w=40 l=2
+  ad=0 pd=0 as=240 ps=92
M1138 a_780_n171# a_563_n64# vdd w_774_n177# CMOSP w=40 l=2
+  ad=400 pd=180 as=0 ps=0
M1139 a_n296_44# a_n345_99# gnd Gnd CMOSN w=40 l=2
+  ad=240 pd=92 as=0 ps=0
M1140 b4 a_n93_n664# vdd w_n74_n684# CMOSP w=40 l=2
+  ad=200 pd=90 as=0 ps=0
M1141 gnd a_851_n360# a_993_n385# Gnd CMOSN w=40 l=2
+  ad=0 pd=0 as=240 ps=92
M1142 a_780_n392# a_576_n345# vdd w_774_n398# CMOSP w=40 l=2
+  ad=400 pd=180 as=0 ps=0
M1143 S3_out a_1227_n283# gnd Gnd CMOSN w=20 l=2
+  ad=100 pd=50 as=0 ps=0
M1144 a_n383_n107# da1 vdd w_n396_n114# CMOSP w=80 l=2
+  ad=480 pd=172 as=0 ps=0
M1145 a_484_43# a_435_98# gnd Gnd CMOSN w=40 l=2
+  ad=240 pd=92 as=0 ps=0
M1146 vdd p2 a_396_n200# w_390_n206# CMOSP w=40 l=2
+  ad=0 pd=0 as=0 ps=0
M1147 a_586_n168# a_397_n152# a_642_n160# Gnd CMOSN w=60 l=2
+  ad=300 pd=130 as=360 ps=132
M1148 a_576_n345# a_396_n371# vdd w_570_n351# CMOSP w=40 l=2
+  ad=0 pd=0 as=0 ps=0
M1149 a_n143_n95# clk vdd w_n156_n101# CMOSP w=40 l=2
+  ad=200 pd=90 as=0 ps=0
M1150 a_n382_n732# da4 gnd Gnd CMOSN w=20 l=2
+  ad=100 pd=50 as=0 ps=0
M1151 gnd a_396_n56# a_625_n57# Gnd CMOSN w=40 l=2
+  ad=0 pd=0 as=240 ps=92
M1152 a0 a_n296_99# gnd Gnd CMOSN w=20 l=2
+  ad=100 pd=50 as=0 ps=0
M1153 Cout_ff a_1230_n664# gnd Gnd CMOSN w=20 l=2
+  ad=100 pd=50 as=0 ps=0
M1154 S3_out a_1227_n283# vdd w_1246_n303# CMOSP w=40 l=2
+  ad=200 pd=90 as=0 ps=0
M1155 a_n184_n352# clk a_n184_n296# w_n197_n303# CMOSP w=80 l=2
+  ad=480 pd=172 as=480 ps=172
M1156 vdd p4 a_396_n521# w_390_n527# CMOSP w=40 l=2
+  ad=0 pd=0 as=0 ps=0
M1157 a_1181_n719# clk gnd Gnd CMOSN w=40 l=2
+  ad=240 pd=92 as=0 ps=0
M1158 vdd a2 a_94_n331# w_88_n337# CMOSP w=40 l=2
+  ad=0 pd=0 as=0 ps=0
M1159 a_23_n560# a4 vdd w_17_n566# CMOSP w=40 l=2
+  ad=400 pd=180 as=0 ps=0
M1160 a_156_n585# b4 a_94_n592# Gnd CMOSN w=40 l=2
+  ad=0 pd=0 as=200 ps=90
M1161 vdd a_851_n203# s2 w_925_n177# CMOSP w=40 l=2
+  ad=0 pd=0 as=0 ps=0
M1162 vdd a_780_n62# a_851_n30# w_845_n36# CMOSP w=40 l=2
+  ad=0 pd=0 as=0 ps=0
M1163 a_608_n570# a_396_n521# a_608_n578# Gnd CMOSN w=100 l=2
+  ad=0 pd=0 as=600 ps=212
M1164 vdd a_851_n424# s4 w_925_n398# CMOSP w=40 l=2
+  ad=0 pd=0 as=0 ps=0
M1165 a_397_n152# g0 a_453_n144# Gnd CMOSN w=60 l=2
+  ad=300 pd=130 as=360 ps=132
M1166 a_n384_30# clk a_n384_86# w_n397_79# CMOSP w=80 l=2
+  ad=480 pd=172 as=480 ps=172
M1167 Cout_ff a_1230_n664# vdd w_1249_n684# CMOSP w=40 l=2
+  ad=200 pd=90 as=0 ps=0
M1168 a_n294_n718# a_n343_n663# gnd Gnd CMOSN w=40 l=2
+  ad=0 pd=0 as=0 ps=0
M1169 a_n346_n282# a_n385_n351# a_n346_n337# Gnd CMOSN w=40 l=2
+  ad=200 pd=90 as=240 ps=92
M1170 a_396_n459# p4 vdd w_390_n472# CMOSP w=40 l=2
+  ad=0 pd=0 as=0 ps=0
M1171 gnd a_780_n281# a_913_n306# Gnd CMOSN w=40 l=2
+  ad=0 pd=0 as=240 ps=92
M1172 gnd a_94_n79# a_236_n104# Gnd CMOSN w=40 l=2
+  ad=0 pd=0 as=240 ps=92
M1173 p4 a_94_n528# vdd w_168_n566# CMOSP w=40 l=2
+  ad=400 pd=180 as=0 ps=0
M1174 a_435_98# clk vdd w_422_92# CMOSP w=40 l=2
+  ad=200 pd=90 as=0 ps=0
M1175 vdd a0 a_94_n32# w_88_n38# CMOSP w=40 l=2
+  ad=0 pd=0 as=0 ps=0
M1176 a_94_n442# a_23_n410# vdd w_88_n448# CMOSP w=40 l=2
+  ad=400 pd=180 as=0 ps=0
M1177 a_n295_n94# a_n344_n94# vdd w_n308_n100# CMOSP w=40 l=2
+  ad=200 pd=90 as=0 ps=0
M1178 vdd p1 a_396_n56# w_390_n62# CMOSP w=40 l=2
+  ad=0 pd=0 as=0 ps=0
M1179 a_n384_n542# clk a_n384_n486# w_n397_n493# CMOSP w=80 l=2
+  ad=480 pd=172 as=480 ps=172
M1180 a_n96_n283# clk a_n96_n338# Gnd CMOSN w=40 l=2
+  ad=200 pd=90 as=240 ps=92
M1181 g0 a_94_n32# vdd w_215_n55# CMOSP w=40 l=2
+  ad=200 pd=90 as=0 ps=0
M1182 c5 a_396_n459# vdd w_546_n607# CMOSP w=40 l=2
+  ad=0 pd=0 as=0 ps=0
M1183 a_1229_n95# clk a_1229_n150# Gnd CMOSN w=40 l=2
+  ad=200 pd=90 as=0 ps=0
M1184 a_n181_n733# clk a_n181_n677# w_n194_n684# CMOSP w=80 l=2
+  ad=480 pd=172 as=480 ps=172
M1185 a_1179_n474# clk vdd w_1166_n480# CMOSP w=40 l=2
+  ad=200 pd=90 as=0 ps=0
M1186 gnd a2 a_85_n254# Gnd CMOSN w=40 l=2
+  ad=0 pd=0 as=240 ps=92
M1187 vdd p1 a_780_n62# w_774_n68# CMOSP w=40 l=2
+  ad=0 pd=0 as=0 ps=0
M1188 a_85_45# b0 a_23_38# Gnd CMOSN w=40 l=2
+  ad=240 pd=92 as=200 ps=90
M1189 a_94_n378# a3 vdd w_88_n384# CMOSP w=40 l=2
+  ad=400 pd=180 as=0 ps=0
M1190 vdd p2 a_851_n203# w_845_n209# CMOSP w=40 l=2
+  ad=0 pd=0 as=0 ps=0
M1191 a_n183_29# db0 gnd Gnd CMOSN w=20 l=2
+  ad=100 pd=50 as=0 ps=0
M1192 a_632_n322# a_397_n323# a_632_n330# Gnd CMOSN w=80 l=2
+  ad=0 pd=0 as=480 ps=172
M1193 b0 a_n95_98# vdd w_n76_78# CMOSP w=40 l=2
+  ad=200 pd=90 as=0 ps=0
M1194 vdd g2 a_397_n560# w_391_n573# CMOSP w=40 l=2
+  ad=0 pd=0 as=0 ps=0
M1195 a_n346_n282# clk vdd w_n359_n288# CMOSP w=40 l=2
+  ad=200 pd=90 as=0 ps=0
M1196 gnd a_23_n111# a_156_n136# Gnd CMOSN w=40 l=2
+  ad=0 pd=0 as=240 ps=92
M1197 a_94_70# a0 vdd w_88_64# CMOSP w=40 l=2
+  ad=0 pd=0 as=0 ps=0
M1198 a_n343_n663# a_n382_n732# a_n343_n718# Gnd CMOSN w=40 l=2
+  ad=200 pd=90 as=240 ps=92
M1199 a_156_n521# a_23_n560# a_94_n528# Gnd CMOSN w=40 l=2
+  ad=0 pd=0 as=200 ps=90
M1200 a_1178_n283# a_1139_n352# a_1178_n338# Gnd CMOSN w=40 l=2
+  ad=200 pd=90 as=0 ps=0
M1201 a_452_n506# g1 a_452_n514# Gnd CMOSN w=80 l=2
+  ad=0 pd=0 as=480 ps=172
M1202 a_1140_29# s1 gnd Gnd CMOSN w=20 l=2
+  ad=100 pd=50 as=0 ps=0
M1203 a_n184_n352# db2 gnd Gnd CMOSN w=20 l=2
+  ad=100 pd=50 as=0 ps=0
M1204 a_n144_98# clk vdd w_n157_92# CMOSP w=40 l=2
+  ad=200 pd=90 as=0 ps=0
M1205 gnd a_586_n168# a_913_n242# Gnd CMOSN w=40 l=2
+  ad=0 pd=0 as=240 ps=92
M1206 a_n384_30# da0 gnd Gnd CMOSN w=20 l=2
+  ad=100 pd=50 as=0 ps=0
M1207 vdd b2 a_23_n261# w_17_n267# CMOSP w=40 l=2
+  ad=0 pd=0 as=0 ps=0
M1208 vdd p2 a_396_n459# w_390_n472# CMOSP w=40 l=2
+  ad=0 pd=0 as=0 ps=0
M1209 a_94_n79# a1 vdd w_88_n85# CMOSP w=40 l=2
+  ad=400 pd=180 as=0 ps=0
M1210 a_n144_98# a_n183_29# a_n144_43# Gnd CMOSN w=40 l=2
+  ad=200 pd=90 as=240 ps=92
M1211 b3 a_n95_n474# gnd Gnd CMOSN w=20 l=2
+  ad=100 pd=50 as=0 ps=0
M1212 a_n96_n283# a_n145_n283# vdd w_n109_n289# CMOSP w=40 l=2
+  ad=200 pd=90 as=0 ps=0
M1213 a_1179_43# clk gnd Gnd CMOSN w=40 l=2
+  ad=240 pd=92 as=0 ps=0
M1214 a_n93_n664# clk a_n93_n719# Gnd CMOSN w=40 l=2
+  ad=200 pd=90 as=240 ps=92
M1215 S1_out a_1228_98# gnd Gnd CMOSN w=20 l=2
+  ad=100 pd=50 as=0 ps=0
M1216 a_452_n451# p1 a_452_n459# Gnd CMOSN w=100 l=2
+  ad=0 pd=0 as=600 ps=212
M1217 a_n344_n149# clk gnd Gnd CMOSN w=40 l=2
+  ad=0 pd=0 as=0 ps=0
M1218 gnd a0 a_156_77# Gnd CMOSN w=40 l=2
+  ad=0 pd=0 as=0 ps=0
M1219 a_n183_85# db0 vdd w_n196_78# CMOSP w=80 l=2
+  ad=0 pd=0 as=0 ps=0
M1220 vdd p4 a_851_n424# w_845_n430# CMOSP w=40 l=2
+  ad=0 pd=0 as=400 ps=180
M1221 a_1230_n664# a_1181_n664# vdd w_1217_n670# CMOSP w=40 l=2
+  ad=200 pd=90 as=0 ps=0
M1222 a_458_n364# p3 a_396_n371# Gnd CMOSN w=40 l=2
+  ad=0 pd=0 as=200 ps=90
M1223 a_n95_98# a_n144_98# vdd w_n108_92# CMOSP w=40 l=2
+  ad=200 pd=90 as=0 ps=0
M1224 gnd b4 a_156_n623# Gnd CMOSN w=40 l=2
+  ad=0 pd=0 as=240 ps=92
M1225 b3 a_n95_n474# vdd w_n76_n494# CMOSP w=40 l=2
+  ad=200 pd=90 as=0 ps=0
M1226 vdd a_94_n293# p2 w_168_n267# CMOSP w=40 l=2
+  ad=0 pd=0 as=0 ps=0
M1227 a_156_n25# a0 a_94_n32# Gnd CMOSN w=40 l=2
+  ad=0 pd=0 as=200 ps=90
M1228 a_1228_n474# clk a_1228_n529# Gnd CMOSN w=40 l=2
+  ad=200 pd=90 as=0 ps=0
M1229 a_n95_98# clk a_n95_43# Gnd CMOSN w=40 l=2
+  ad=200 pd=90 as=240 ps=92
M1230 a_n343_n663# clk vdd w_n356_n669# CMOSP w=40 l=2
+  ad=200 pd=90 as=0 ps=0
M1231 vdd b1 a_94_n143# w_88_n149# CMOSP w=40 l=2
+  ad=0 pd=0 as=0 ps=0
M1232 gnd a_780_n62# a_913_n87# Gnd CMOSN w=40 l=2
+  ad=0 pd=0 as=0 ps=0
M1233 a_1140_85# s1 vdd w_1127_78# CMOSP w=80 l=2
+  ad=480 pd=172 as=0 ps=0
M1234 a_n182_n108# db1 vdd w_n195_n115# CMOSP w=80 l=2
+  ad=0 pd=0 as=0 ps=0
M1235 a_85_n403# b3 a_23_n410# Gnd CMOSN w=40 l=2
+  ad=0 pd=0 as=200 ps=90
M1236 vdd a_780_n171# a_851_n139# w_845_n145# CMOSP w=40 l=2
+  ad=0 pd=0 as=0 ps=0
M1237 a_396_29# p0 gnd Gnd CMOSN w=20 l=2
+  ad=100 pd=50 as=0 ps=0
M1238 a_1227_n338# a_1178_n283# gnd Gnd CMOSN w=40 l=2
+  ad=240 pd=92 as=0 ps=0
M1239 a_n94_n150# a_n143_n95# gnd Gnd CMOSN w=40 l=2
+  ad=0 pd=0 as=0 ps=0
M1240 a_n384_n542# da3 gnd Gnd CMOSN w=20 l=2
+  ad=100 pd=50 as=0 ps=0
M1241 vdd a_780_n392# a_851_n360# w_845_n366# CMOSP w=40 l=2
+  ad=0 pd=0 as=0 ps=0
M1242 a_397_n323# p2 vdd w_391_n336# CMOSP w=40 l=2
+  ad=0 pd=0 as=0 ps=0
M1243 a_n181_n733# db4 gnd Gnd CMOSN w=20 l=2
+  ad=100 pd=50 as=0 ps=0
M1244 gnd a_94_n378# a_236_n403# Gnd CMOSN w=40 l=2
+  ad=0 pd=0 as=240 ps=92
M1245 vdd a_94_6# p0 w_168_32# CMOSP w=40 l=2
+  ad=0 pd=0 as=400 ps=180
M1246 a_608_n594# a_94_n630# gnd Gnd CMOSN w=100 l=2
+  ad=0 pd=0 as=0 ps=0
M1247 a_453_n323# p3 gnd Gnd CMOSN w=60 l=2
+  ad=0 pd=0 as=0 ps=0
M1248 a_397_n560# p3 a_453_n552# Gnd CMOSN w=60 l=2
+  ad=300 pd=130 as=360 ps=132
M1249 a1 a_n295_n94# gnd Gnd CMOSN w=20 l=2
+  ad=100 pd=50 as=0 ps=0
M1250 a_1141_n164# s2 gnd Gnd CMOSN w=20 l=2
+  ad=100 pd=50 as=0 ps=0
M1251 a_n93_n664# a_n142_n664# vdd w_n106_n670# CMOSP w=40 l=2
+  ad=200 pd=90 as=0 ps=0
M1252 a_396_n284# g0 vdd w_390_n290# CMOSP w=40 l=2
+  ad=0 pd=0 as=0 ps=0
M1253 a_n385_n295# da2 vdd w_n398_n302# CMOSP w=80 l=2
+  ad=0 pd=0 as=0 ps=0
M1254 a_n296_n528# a_n345_n473# gnd Gnd CMOSN w=40 l=2
+  ad=0 pd=0 as=0 ps=0
M1255 gnd a_780_n392# a_913_n417# Gnd CMOSN w=40 l=2
+  ad=0 pd=0 as=0 ps=0
M1256 a_452_n269# p2 a_452_n277# Gnd CMOSN w=80 l=2
+  ad=0 pd=0 as=0 ps=0
M1257 a_396_n521# p3 a_452_n498# Gnd CMOSN w=80 l=2
+  ad=400 pd=170 as=0 ps=0
M1258 vdd g3 a_396_n608# w_390_n614# CMOSP w=40 l=2
+  ad=0 pd=0 as=0 ps=0
M1259 a_n145_n283# a_n184_n352# a_n145_n338# Gnd CMOSN w=40 l=2
+  ad=200 pd=90 as=240 ps=92
M1260 vdd a4 a_94_n630# w_88_n636# CMOSP w=40 l=2
+  ad=0 pd=0 as=0 ps=0
M1261 a_396_n459# p3 a_452_n435# Gnd CMOSN w=100 l=2
+  ad=500 pd=210 as=600 ps=212
M1262 a_396_85# p0 vdd w_383_78# CMOSP w=80 l=2
+  ad=0 pd=0 as=0 ps=0
M1263 gnd a1 a_156_n72# Gnd CMOSN w=40 l=2
+  ad=0 pd=0 as=240 ps=92
M1264 vdd a_396_n608# c5 w_546_n607# CMOSP w=40 l=2
+  ad=0 pd=0 as=0 ps=0
M1265 a_1229_n95# a_1180_n95# vdd w_1216_n101# CMOSP w=40 l=2
+  ad=200 pd=90 as=0 ps=0
M1266 a_396_n371# g2 vdd w_390_n377# CMOSP w=40 l=2
+  ad=400 pd=180 as=0 ps=0
M1267 a_94_n181# b1 vdd w_88_n187# CMOSP w=40 l=2
+  ad=400 pd=180 as=0 ps=0
M1268 a_397_n152# p2 vdd w_391_n165# CMOSP w=40 l=2
+  ad=0 pd=0 as=0 ps=0
M1269 a_n183_n543# clk a_n183_n487# w_n196_n494# CMOSP w=80 l=2
+  ad=480 pd=172 as=480 ps=172
M1270 gnd a_586_n168# a_842_n274# Gnd CMOSN w=40 l=2
+  ad=0 pd=0 as=240 ps=92
M1271 a_563_n64# a_396_n56# vdd w_557_n70# CMOSP w=40 l=2
+  ad=0 pd=0 as=0 ps=0
M1272 a_23_38# a0 vdd w_17_32# CMOSP w=40 l=2
+  ad=0 pd=0 as=0 ps=0
M1273 a_156_n324# a2 a_94_n331# Gnd CMOSN w=40 l=2
+  ad=0 pd=0 as=200 ps=90
M1274 a_1139_n352# clk a_1139_n296# w_1126_n303# CMOSP w=80 l=2
+  ad=480 pd=172 as=0 ps=0
M1275 a_n382_n676# da4 vdd w_n395_n683# CMOSP w=80 l=2
+  ad=0 pd=0 as=0 ps=0
M1276 a1 a_n295_n94# vdd w_n276_n114# CMOSP w=40 l=2
+  ad=200 pd=90 as=0 ps=0
M1277 a_n345_n473# a_n384_n542# a_n345_n528# Gnd CMOSN w=40 l=2
+  ad=200 pd=90 as=240 ps=92
M1278 a_n145_n283# clk vdd w_n158_n289# CMOSP w=40 l=2
+  ad=200 pd=90 as=0 ps=0
M1279 a_1140_n543# s4 gnd Gnd CMOSN w=20 l=2
+  ad=100 pd=50 as=0 ps=0
M1280 a_n142_n664# a_n181_n733# a_n142_n719# Gnd CMOSN w=40 l=2
+  ad=200 pd=90 as=240 ps=92
M1281 p1 a_94_n79# vdd w_168_n117# CMOSP w=40 l=2
+  ad=0 pd=0 as=0 ps=0
M1282 a_94_n293# a_23_n261# vdd w_88_n299# CMOSP w=40 l=2
+  ad=400 pd=180 as=0 ps=0
M1283 gnd a4 a_85_n553# Gnd CMOSN w=40 l=2
+  ad=0 pd=0 as=240 ps=92
M1284 a_993_n164# a_851_n203# s2 Gnd CMOSN w=40 l=2
+  ad=0 pd=0 as=200 ps=90
M1285 vdd p2 a_780_n171# w_774_n177# CMOSP w=40 l=2
+  ad=0 pd=0 as=0 ps=0
M1286 a_993_n385# a_851_n424# s4 Gnd CMOSN w=40 l=2
+  ad=0 pd=0 as=200 ps=90
M1287 vdd p4 a_780_n392# w_774_n398# CMOSP w=40 l=2
+  ad=0 pd=0 as=0 ps=0
M1288 gnd g1 a_458_n193# Gnd CMOSN w=40 l=2
+  ad=0 pd=0 as=240 ps=92
M1289 a_n95_n474# clk a_n95_n529# Gnd CMOSN w=40 l=2
+  ad=200 pd=90 as=240 ps=92
M1290 gnd a_23_n410# a_156_n435# Gnd CMOSN w=40 l=2
+  ad=0 pd=0 as=240 ps=92
M1291 a_1180_n150# clk gnd Gnd CMOSN w=40 l=2
+  ad=240 pd=92 as=0 ps=0
M1292 a_642_n160# a_396_n200# a_642_n168# Gnd CMOSN w=60 l=2
+  ad=0 pd=0 as=0 ps=0
M1293 g3 a_94_n480# gnd Gnd CMOSN w=20 l=2
+  ad=100 pd=50 as=0 ps=0
M1294 a_n143_n150# clk gnd Gnd CMOSN w=40 l=2
+  ad=0 pd=0 as=0 ps=0
M1295 a_n94_n95# a_n143_n95# vdd w_n107_n101# CMOSP w=40 l=2
+  ad=200 pd=90 as=0 ps=0
M1296 a_1228_98# clk a_1228_43# Gnd CMOSN w=40 l=2
+  ad=200 pd=90 as=0 ps=0
M1297 vdd b4 a_23_n560# w_17_n566# CMOSP w=40 l=2
+  ad=0 pd=0 as=0 ps=0
M1298 a_n345_n473# clk vdd w_n358_n479# CMOSP w=40 l=2
+  ad=200 pd=90 as=0 ps=0
M1299 gnd a3 a_156_n371# Gnd CMOSN w=40 l=2
+  ad=0 pd=0 as=240 ps=92
M1300 a_453_n144# p1 a_453_n152# Gnd CMOSN w=60 l=2
+  ad=0 pd=0 as=360 ps=132
M1301 a_n142_n664# clk vdd w_n155_n670# CMOSP w=40 l=2
+  ad=200 pd=90 as=0 ps=0
M1302 a_236_n104# a_94_n143# p1 Gnd CMOSN w=40 l=2
+  ad=0 pd=0 as=200 ps=90
M1303 a_n183_n543# db3 gnd Gnd CMOSN w=20 l=2
+  ad=100 pd=50 as=0 ps=0
M1304 vdd p3 a_396_n284# w_390_n290# CMOSP w=40 l=2
+  ad=0 pd=0 as=0 ps=0
M1305 vdd a_94_n592# p4 w_168_n566# CMOSP w=40 l=2
+  ad=0 pd=0 as=0 ps=0
M1306 vdd p2 a_396_n521# w_390_n527# CMOSP w=40 l=2
+  ad=0 pd=0 as=0 ps=0
M1307 a_n95_n474# a_n144_n474# vdd w_n108_n480# CMOSP w=40 l=2
+  ad=200 pd=90 as=0 ps=0
M1308 a_94_n229# a2 vdd w_88_n235# CMOSP w=40 l=2
+  ad=0 pd=0 as=0 ps=0
M1309 a_n295_n94# clk a_n295_n149# Gnd CMOSN w=40 l=2
+  ad=200 pd=90 as=0 ps=0
M1310 a_n297_n282# clk a_n297_n337# Gnd CMOSN w=40 l=2
+  ad=200 pd=90 as=0 ps=0
M1311 vdd b3 a_94_n442# w_88_n448# CMOSP w=40 l=2
+  ad=0 pd=0 as=0 ps=0
M1312 a_n184_n296# db2 vdd w_n197_n303# CMOSP w=80 l=2
+  ad=0 pd=0 as=0 ps=0
M1313 a_1181_n664# a_1142_n733# a_1181_n719# Gnd CMOSN w=40 l=2
+  ad=200 pd=90 as=0 ps=0
M1314 s3 a_851_n249# vdd w_925_n287# CMOSP w=40 l=2
+  ad=0 pd=0 as=0 ps=0
M1315 a_1179_n529# clk gnd Gnd CMOSN w=40 l=2
+  ad=0 pd=0 as=0 ps=0
M1316 vdd a_396_n521# c5 w_546_n607# CMOSP w=40 l=2
+  ad=0 pd=0 as=0 ps=0
M1317 a_484_98# clk a_484_43# Gnd CMOSN w=40 l=2
+  ad=200 pd=90 as=0 ps=0
M1318 gnd a_780_n171# a_913_n196# Gnd CMOSN w=40 l=2
+  ad=0 pd=0 as=0 ps=0
M1319 a_n345_99# clk vdd w_n358_93# CMOSP w=40 l=2
+  ad=200 pd=90 as=0 ps=0
M1320 a_576_n345# a_396_n284# vdd w_570_n351# CMOSP w=40 l=2
+  ad=0 pd=0 as=0 ps=0
M1321 a_n346_n337# clk gnd Gnd CMOSN w=40 l=2
+  ad=0 pd=0 as=0 ps=0
M1322 a_85_n254# b2 a_23_n261# Gnd CMOSN w=40 l=2
+  ad=0 pd=0 as=200 ps=90
M1323 gnd a0 a_85_45# Gnd CMOSN w=40 l=2
+  ad=0 pd=0 as=0 ps=0
M1324 vdd a_23_n410# a_94_n378# w_88_n384# CMOSP w=40 l=2
+  ad=0 pd=0 as=0 ps=0
M1325 g3 a_94_n480# vdd w_214_n503# CMOSP w=40 l=2
+  ad=200 pd=90 as=0 ps=0
M1326 a_913_n306# p3 a_851_n313# Gnd CMOSN w=40 l=2
+  ad=0 pd=0 as=200 ps=90
M1327 a_n345_99# a_n384_30# a_n345_44# Gnd CMOSN w=40 l=2
+  ad=200 pd=90 as=0 ps=0
M1328 a_397_n560# p4 vdd w_391_n573# CMOSP w=40 l=2
+  ad=0 pd=0 as=0 ps=0
M1329 a_632_n330# a_396_n371# a_632_n338# Gnd CMOSN w=80 l=2
+  ad=0 pd=0 as=0 ps=0
M1330 a_851_n94# a_780_n62# vdd w_845_n100# CMOSP w=40 l=2
+  ad=0 pd=0 as=0 ps=0
M1331 a_156_n136# b1 a_94_n143# Gnd CMOSN w=40 l=2
+  ad=0 pd=0 as=200 ps=90
M1332 a_452_n514# p4 gnd Gnd CMOSN w=80 l=2
+  ad=0 pd=0 as=0 ps=0
M1333 a_94_6# a_23_38# vdd w_88_0# CMOSP w=40 l=2
+  ad=0 pd=0 as=0 ps=0
M1334 a_n384_86# da0 vdd w_n397_79# CMOSP w=80 l=2
+  ad=0 pd=0 as=0 ps=0
M1335 a_n384_n486# da3 vdd w_n397_n493# CMOSP w=80 l=2
+  ad=0 pd=0 as=0 ps=0
M1336 a_n96_n338# a_n145_n283# gnd Gnd CMOSN w=40 l=2
+  ad=0 pd=0 as=0 ps=0
M1337 a_913_n242# a_780_n281# a_851_n249# Gnd CMOSN w=40 l=2
+  ad=0 pd=0 as=200 ps=90
M1338 a_396_n459# g0 vdd w_390_n472# CMOSP w=40 l=2
+  ad=0 pd=0 as=0 ps=0
M1339 vdd a_23_n111# a_94_n79# w_88_n85# CMOSP w=40 l=2
+  ad=0 pd=0 as=0 ps=0
M1340 a_n181_n677# db4 vdd w_n194_n684# CMOSP w=80 l=2
+  ad=0 pd=0 as=0 ps=0
M1341 a_1230_n719# a_1181_n664# gnd Gnd CMOSN w=40 l=2
+  ad=0 pd=0 as=0 ps=0
M1342 a_n144_n474# a_n183_n543# a_n144_n529# Gnd CMOSN w=40 l=2
+  ad=200 pd=90 as=0 ps=0
M1343 a_94_n480# b3 vdd w_88_n486# CMOSP w=40 l=2
+  ad=0 pd=0 as=0 ps=0
M1344 a_851_n313# a_780_n281# vdd w_845_n319# CMOSP w=40 l=2
+  ad=0 pd=0 as=0 ps=0
M1345 a_452_n459# p4 gnd Gnd CMOSN w=100 l=2
+  ad=0 pd=0 as=0 ps=0
M1346 a_586_n168# a_94_n331# vdd w_580_n181# CMOSP w=40 l=2
+  ad=0 pd=0 as=0 ps=0
M1347 a_435_43# clk gnd Gnd CMOSN w=40 l=2
+  ad=0 pd=0 as=0 ps=0
M1348 a_1178_n283# clk vdd w_1165_n289# CMOSP w=40 l=2
+  ad=200 pd=90 as=0 ps=0
M1349 a_156_n623# a4 a_94_n630# Gnd CMOSN w=40 l=2
+  ad=0 pd=0 as=200 ps=90
M1350 gnd a_94_n229# a_236_n254# Gnd CMOSN w=40 l=2
+  ad=0 pd=0 as=0 ps=0
M1351 S0_out a_484_98# gnd Gnd CMOSN w=20 l=2
+  ad=100 pd=50 as=0 ps=0
M1352 a_n343_n718# clk gnd Gnd CMOSN w=40 l=2
+  ad=0 pd=0 as=0 ps=0
M1353 gnd p4 a_458_n601# Gnd CMOSN w=40 l=2
+  ad=0 pd=0 as=0 ps=0
M1354 gnd a_23_38# a_156_13# Gnd CMOSN w=40 l=2
+  ad=0 pd=0 as=0 ps=0
M1355 a2 a_n297_n282# vdd w_n278_n302# CMOSP w=40 l=2
+  ad=200 pd=90 as=0 ps=0
M1356 gnd a_563_n64# a_913_n132# Gnd CMOSN w=40 l=2
+  ad=0 pd=0 as=0 ps=0
M1357 gnd a_576_n345# a_913_n353# Gnd CMOSN w=40 l=2
+  ad=0 pd=0 as=0 ps=0
M1358 gnd b1 a_156_n174# Gnd CMOSN w=40 l=2
+  ad=0 pd=0 as=0 ps=0
M1359 a_94_n592# a_23_n560# vdd w_88_n598# CMOSP w=40 l=2
+  ad=0 pd=0 as=0 ps=0
M1360 vdd g1 a_397_n323# w_391_n336# CMOSP w=40 l=2
+  ad=0 pd=0 as=0 ps=0
M1361 gnd g0 a_913_n23# Gnd CMOSN w=40 l=2
+  ad=0 pd=0 as=0 ps=0
M1362 p0 a_94_70# vdd w_168_32# CMOSP w=40 l=2
+  ad=0 pd=0 as=0 ps=0
M1363 a_n93_n719# a_n142_n664# gnd Gnd CMOSN w=40 l=2
+  ad=0 pd=0 as=0 ps=0
M1364 a_453_n552# g2 a_453_n560# Gnd CMOSN w=60 l=2
+  ad=0 pd=0 as=0 ps=0
M1365 a_1141_n108# s2 vdd w_1128_n115# CMOSP w=80 l=2
+  ad=0 pd=0 as=0 ps=0
M1366 a_n144_n474# clk vdd w_n157_n480# CMOSP w=40 l=2
+  ad=200 pd=90 as=0 ps=0
M1367 vdd p1 a_396_n284# w_390_n290# CMOSP w=40 l=2
+  ad=0 pd=0 as=0 ps=0
M1368 a_1228_n474# a_1179_n474# vdd w_1215_n480# CMOSP w=40 l=2
+  ad=200 pd=90 as=0 ps=0
M1369 a4 a_n294_n663# gnd Gnd CMOSN w=20 l=2
+  ad=100 pd=50 as=0 ps=0
M1370 a_n144_43# clk gnd Gnd CMOSN w=40 l=2
+  ad=0 pd=0 as=0 ps=0
M1371 gnd a_23_n261# a_156_n286# Gnd CMOSN w=40 l=2
+  ad=0 pd=0 as=0 ps=0
M1372 a_851_n249# a_586_n168# vdd w_845_n255# CMOSP w=40 l=2
+  ad=0 pd=0 as=0 ps=0
M1373 a_1179_98# a_1140_29# a_1179_43# Gnd CMOSN w=40 l=2
+  ad=200 pd=90 as=0 ps=0
M1374 a_1142_n733# clk a_1142_n677# w_1129_n684# CMOSP w=80 l=2
+  ad=480 pd=172 as=0 ps=0
M1375 gnd g0 a_458_n49# Gnd CMOSN w=40 l=2
+  ad=0 pd=0 as=0 ps=0
M1376 a_452_n435# p2 a_452_n443# Gnd CMOSN w=100 l=2
+  ad=0 pd=0 as=0 ps=0
M1377 a_1227_n283# clk a_1227_n338# Gnd CMOSN w=40 l=2
+  ad=200 pd=90 as=0 ps=0
M1378 a_1140_n487# s4 vdd w_1127_n494# CMOSP w=80 l=2
+  ad=0 pd=0 as=0 ps=0
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
