Akshaybunny18/5bit-CLA-Adder-VLSI/Ngspice/Pre_layout/flipflop.cir

* Akshay Chanda 2024102014 
.include TSMC_180nm.txt
.param LAMBDA = 0.09u
.global gnd vdd
.param k = 2

.subckt dff in clk out vdd gnd

.param k=2

M1 c1a in vdd vdd CMOSP W={k*40*LAMBDA} L={2*LAMBDA}
+ AS={5*k*40*LAMBDA*LAMBDA} PS={10*LAMBDA+2*k*40*LAMBDA} 
+ AD={5*k*40*LAMBDA*LAMBDA} PD={10*LAMBDA+2*k*40*LAMBDA}
M2 c1b clk c1a vdd CMOSP W={k*40*LAMBDA} L={2*LAMBDA}
+ AS={5*k*40*LAMBDA*LAMBDA} PS={10*LAMBDA+2*k*40*LAMBDA} 
+ AD={5*k*40*LAMBDA*LAMBDA} PD={10*LAMBDA+2*k*40*LAMBDA}
M3 c1b in gnd gnd CMOSN W={20*LAMBDA} L={2*LAMBDA}
+ AS={5*20*LAMBDA*LAMBDA} PS={10*LAMBDA+2*20*LAMBDA}
+ AD={5*20*LAMBDA*LAMBDA} PD={10*LAMBDA+2*20*LAMBDA}

M4 c2a clk vdd vdd CMOSP W={k*20*LAMBDA} L={2*LAMBDA}
+ AS={5*k*20*LAMBDA*LAMBDA} PS={10*LAMBDA+2*k*20*LAMBDA}
+ AD={5*k*20*LAMBDA*LAMBDA} PD={10*LAMBDA+2*k*20*LAMBDA}
M5 c2a c1b c2b gnd CMOSN W={40*LAMBDA} L={2*LAMBDA}
+ AS={5*40*LAMBDA*LAMBDA} PS={10*LAMBDA+2*40*LAMBDA}
+ AD={5*40*LAMBDA*LAMBDA} PD={10*LAMBDA+2*40*LAMBDA}
M6 c2b clk gnd gnd CMOSN W={40*LAMBDA} L={2*LAMBDA}
+ AS={5*40*LAMBDA*LAMBDA} PS={10*LAMBDA+2*40*LAMBDA}
+ AD={5*40*LAMBDA*LAMBDA} PD={10*LAMBDA+2*40*LAMBDA}
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
